CRAWlab/RoboBoat-2021/README.md

# RoboBoat 2021
General repository for the [University of Louisiana at Lafayette](https://louisiana.edu) entry into the [2021 RoboBoat competition](https://roboboat.org). Our ROS workspace is contained in a [separate repository](https://github.com/CRAWlab/roboboat).
