CRAWlab/RoboBoat-2021/docs/movies/ASV Simulation.md

<center>
  <a href="https://crawlab.github.io/RoboBoat-2021/">UAV</a>
  <a href="https://crawlab.github.io/RoboBoat-2021/Simulation">Simulations</a>
</center>

<p><center>
  <a href="https://crawlab.github.io/RoboBoat-2021/UAV Simulation">UAV Simulation</a>
  <a href="https://crawlab.github.io/RoboBoat-2021/ASV Simulation">ASV Simulation</a>
  <a href="https://crawlab.github.io/RoboBoat-2021/Blender">Blender</a>
  <a href="https://crawlab.github.io/RoboBoat-2021/Labelbox">Labelbox</a>
</center>
</p>

## 2021 UL Lafayette Ragin' Cajuns ASV Simulation

*More Coming soon...*
