CRAWlab/RoboBoat-2021/Technical Report/2021_RaginCajunsRoboBoat_TDR/TDR/Figures/ASV_fieldOfView_gray.pdf

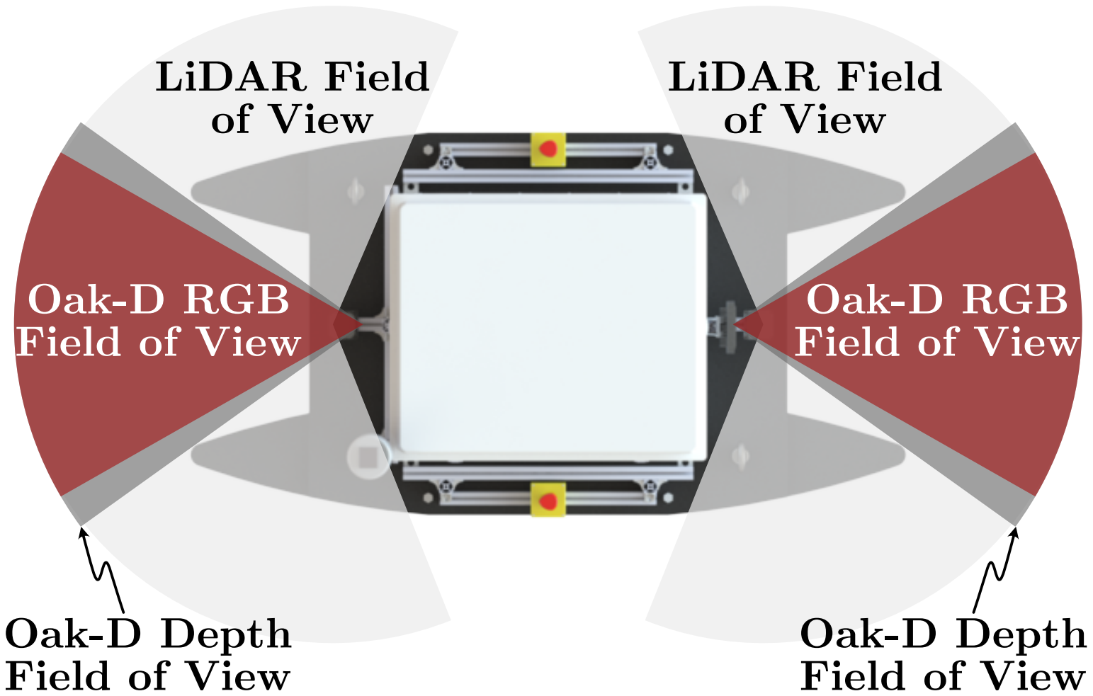
[picture p4: figure]
LiDAR Field of View; Oak-D RGB Field of View; Oak-D Depth Field of View
