CRAWlab/RoboBoat-2021/Technical Report/2021_RaginCajunsRoboBoat_TDR/TDR/Figures/uav_fully_labeled (2).pdf

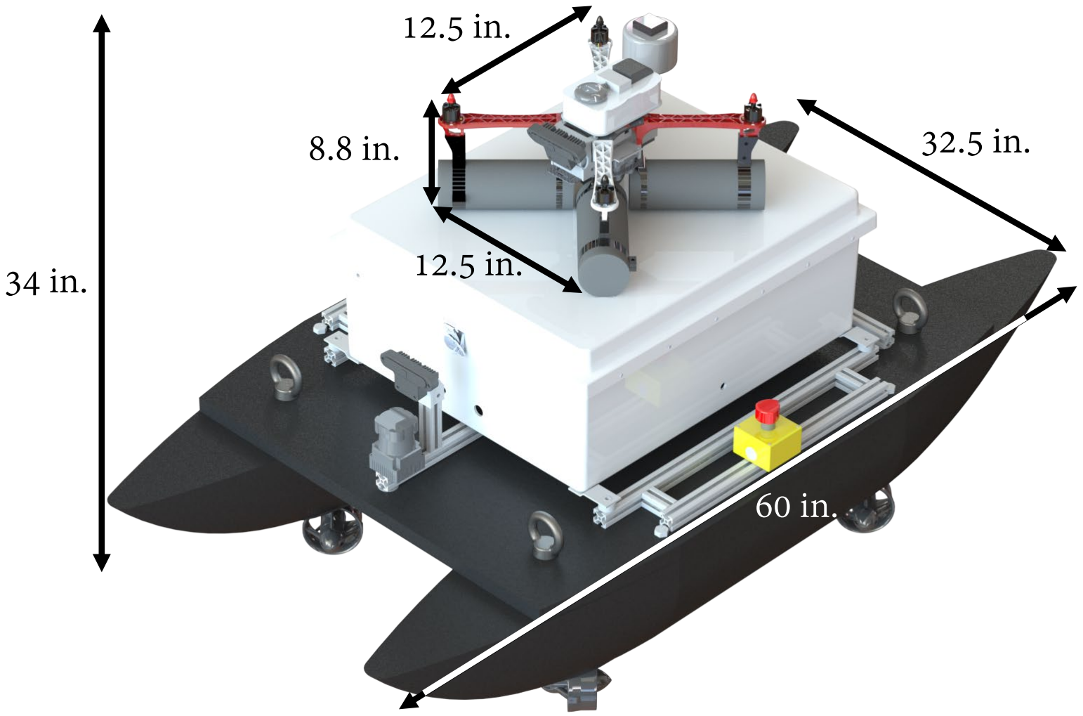
[picture p5: page 1]

32.5 in.

60 in.

34 in.

12.5 in.

8.8 in.

12.5 in.

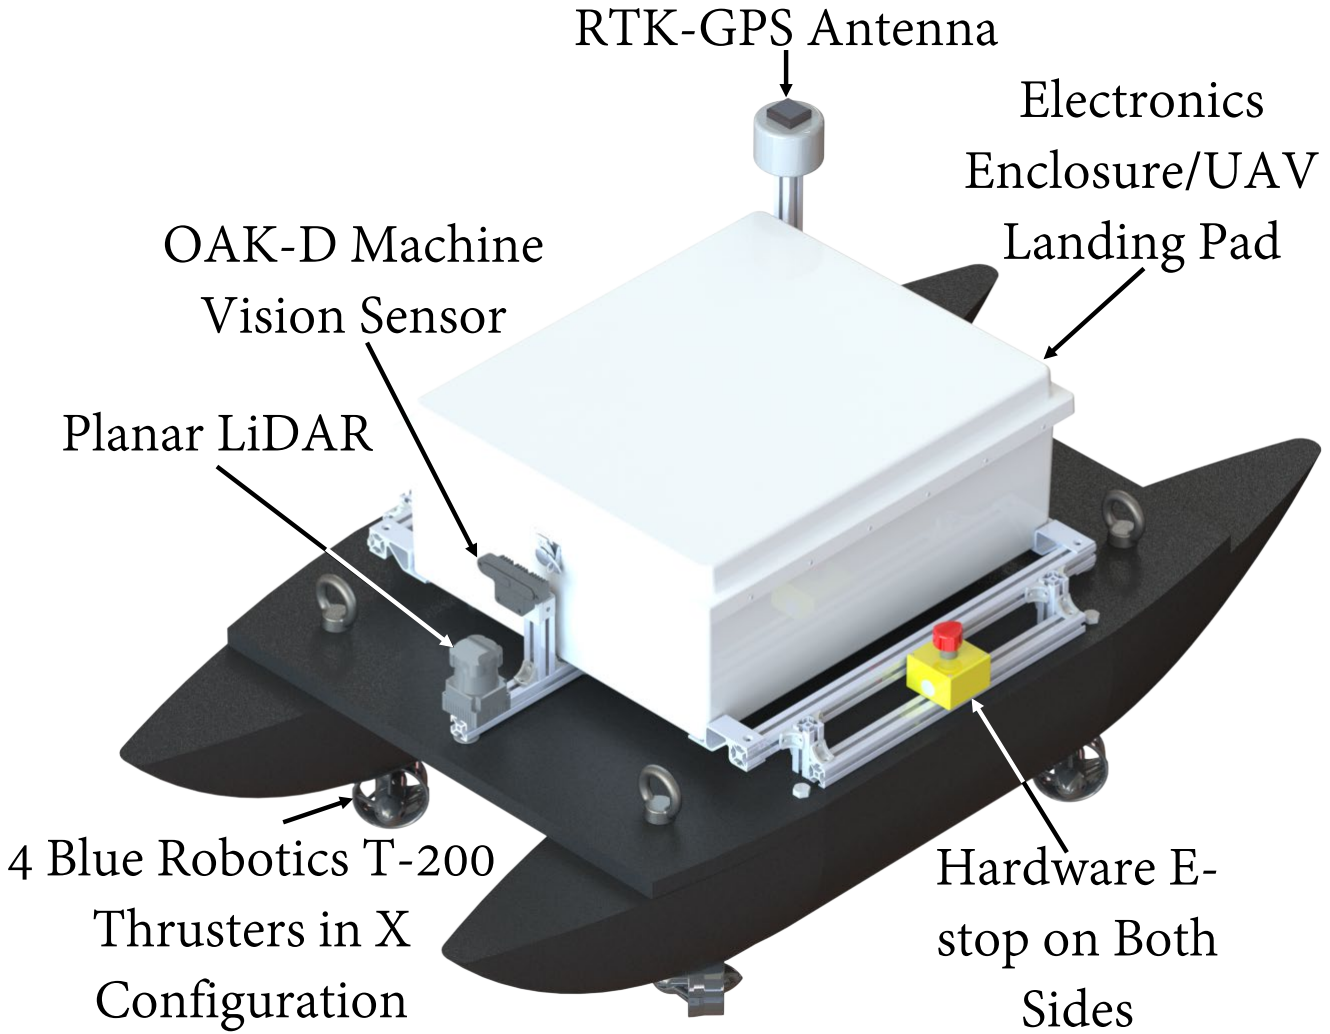
[picture p6: page 2]

Electronics
Enclosure/UAV
Landing Pad

Hardware E-stop on Both
Sides

4 Blue Robotics T-200
Thrusters in X
Configuration

Planar LiDAR

OAK-D Machine
Vision Sensor

RTK-GPS Antenna

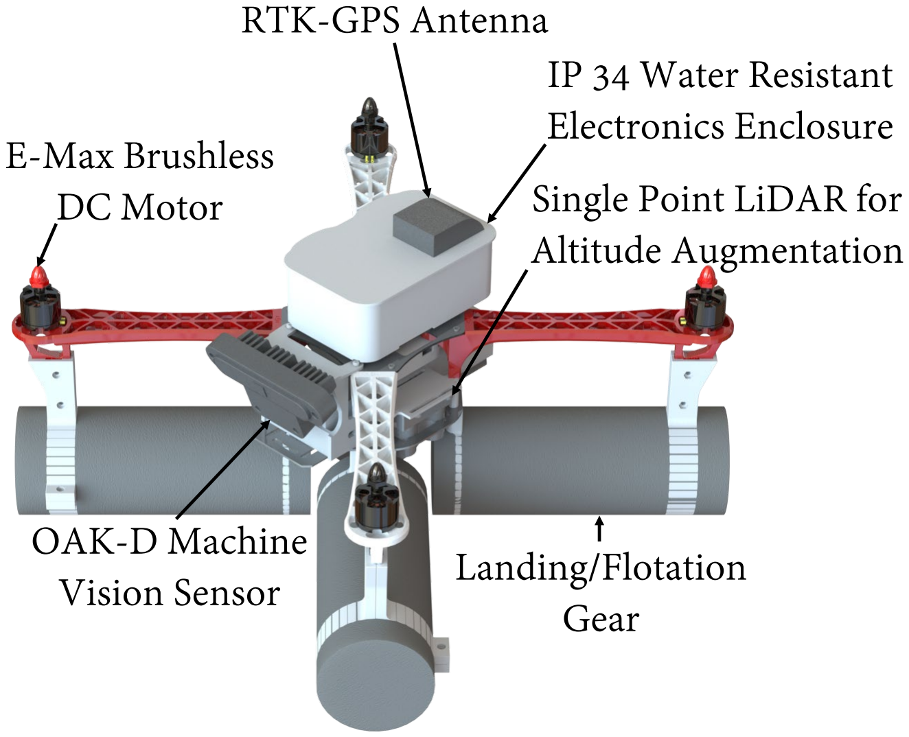
[picture p7: page 3]

IP 34 Water Resistant
Electronics Enclosure
E-Max Brushless
DC Motor

OAK-D Machine
Vision Sensor | Landing/Flotation
| Gear

Single Point LiDAR for
Altitude Augmentation

RTK-GPS Antenna

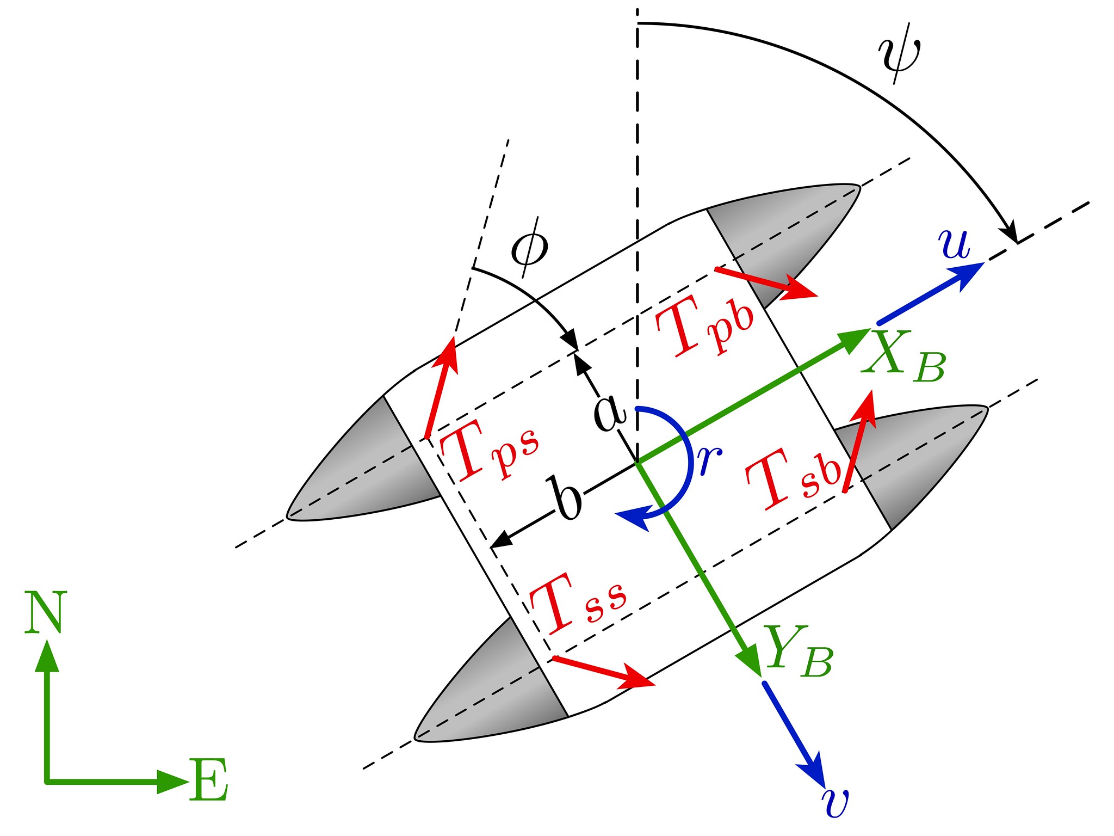
[picture p8: page 4]
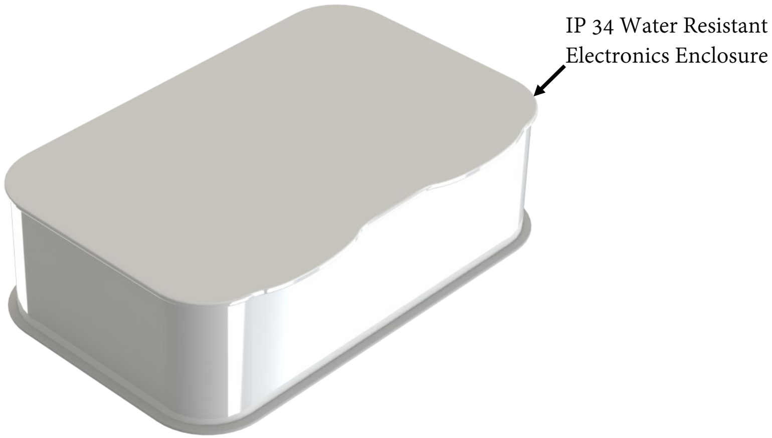
[picture p9: page 5]

IP 34 Water Resistant
Electronics Enclosure

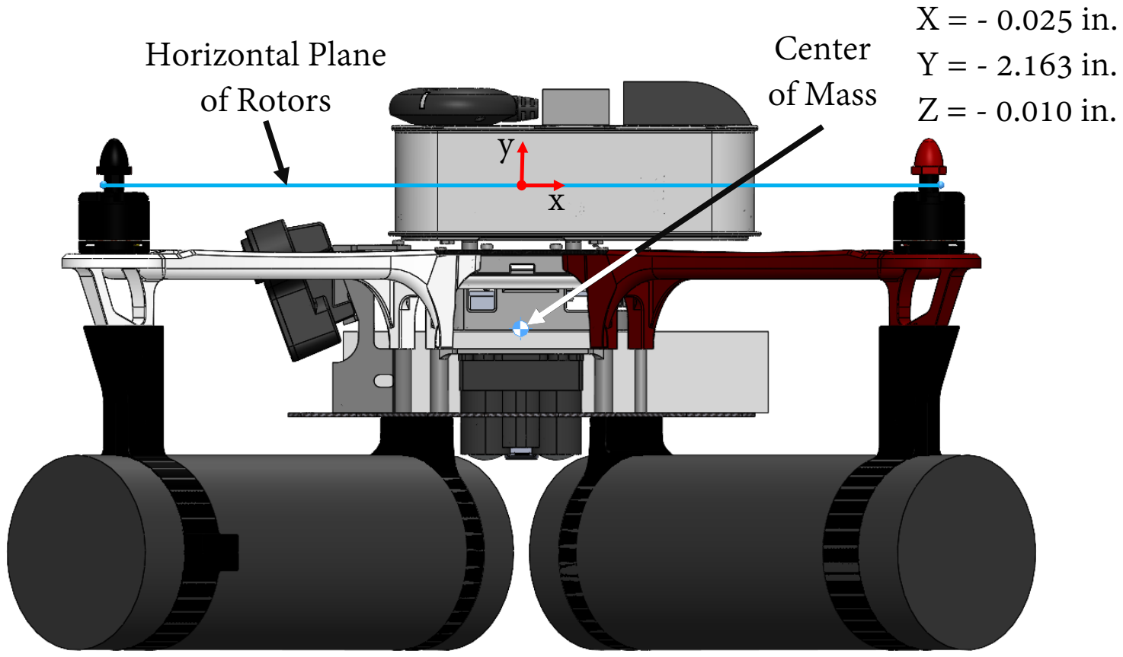
[picture p10: page 6]

y
x

Center
of Mass

X =

- 0.025 in.
Y =
- 2.163 in.
Z =
- 0.010 in.

Horizontal Plane
of Rotors

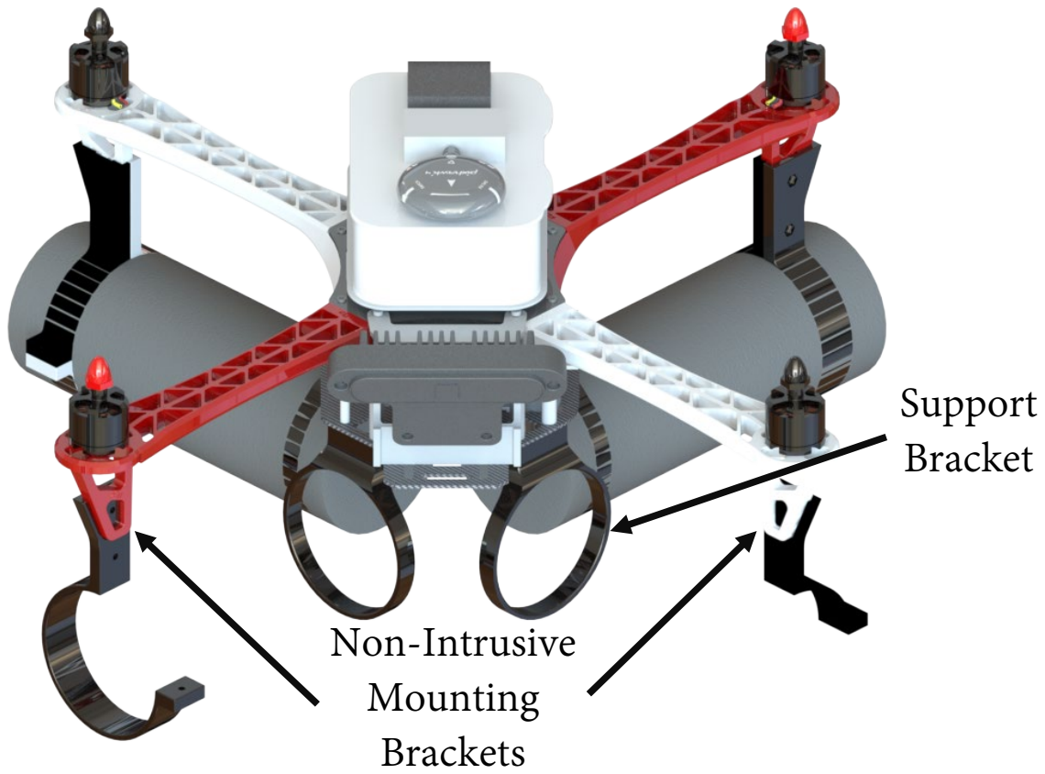
[picture p11: page 7]

Non-Intrusive
Mounting
Brackets

Support
Bracket

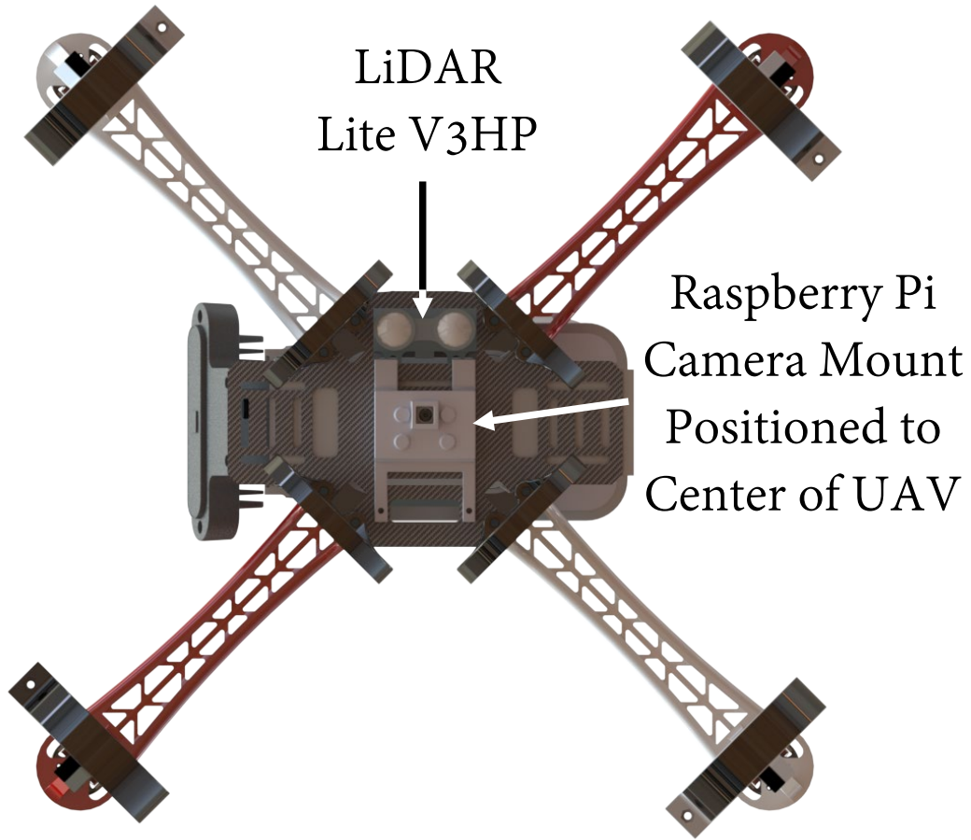
[picture p12: page 8]

### Raspberry Pi Camera Mount Positioned to Center of UAV

### LiDAR Lite V3HP

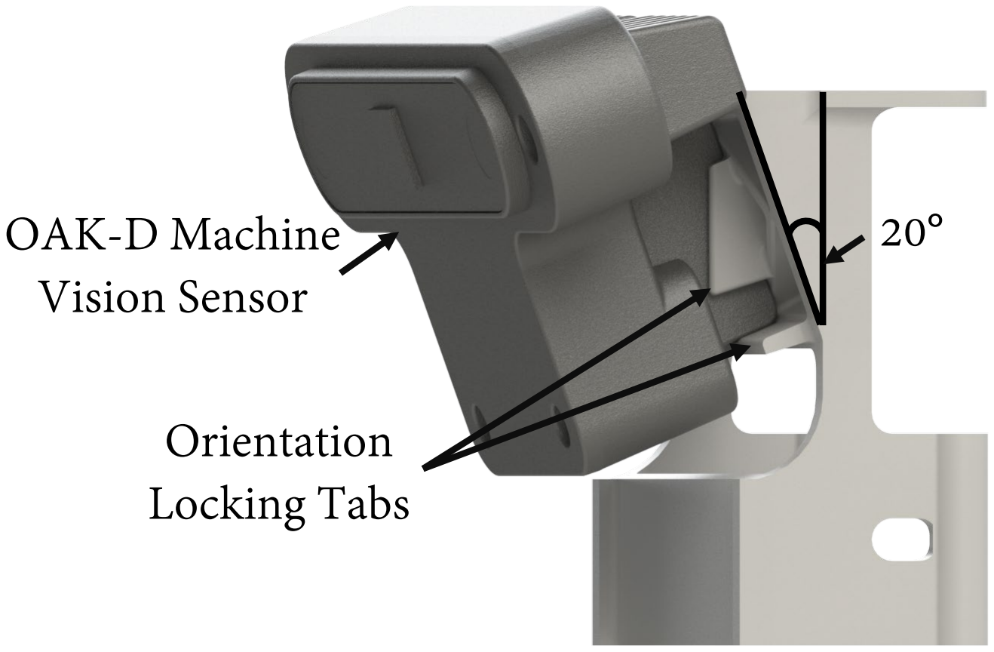
[picture p13: page 9]

### Orientation Locking Tabs

### OAK-D Machine Vision Sensor

20°

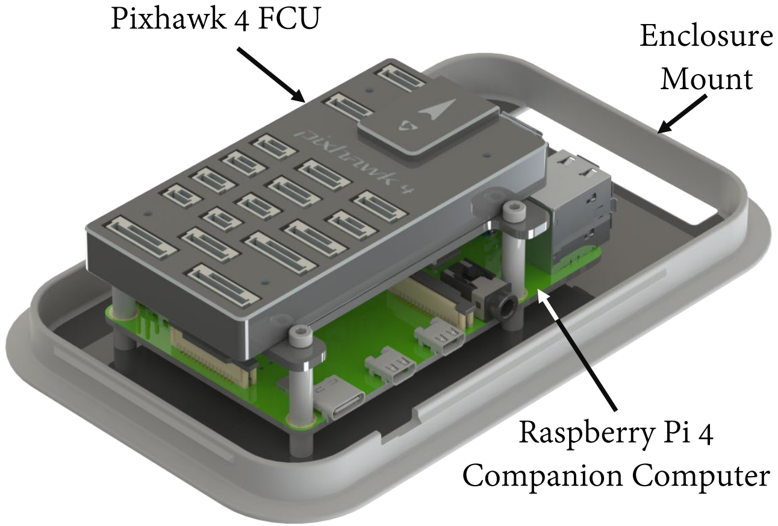
[picture p14: page 10]

### Pixhawk 4 FCU

### Raspberry Pi 4 Companion Computer

### Enclosure Mount

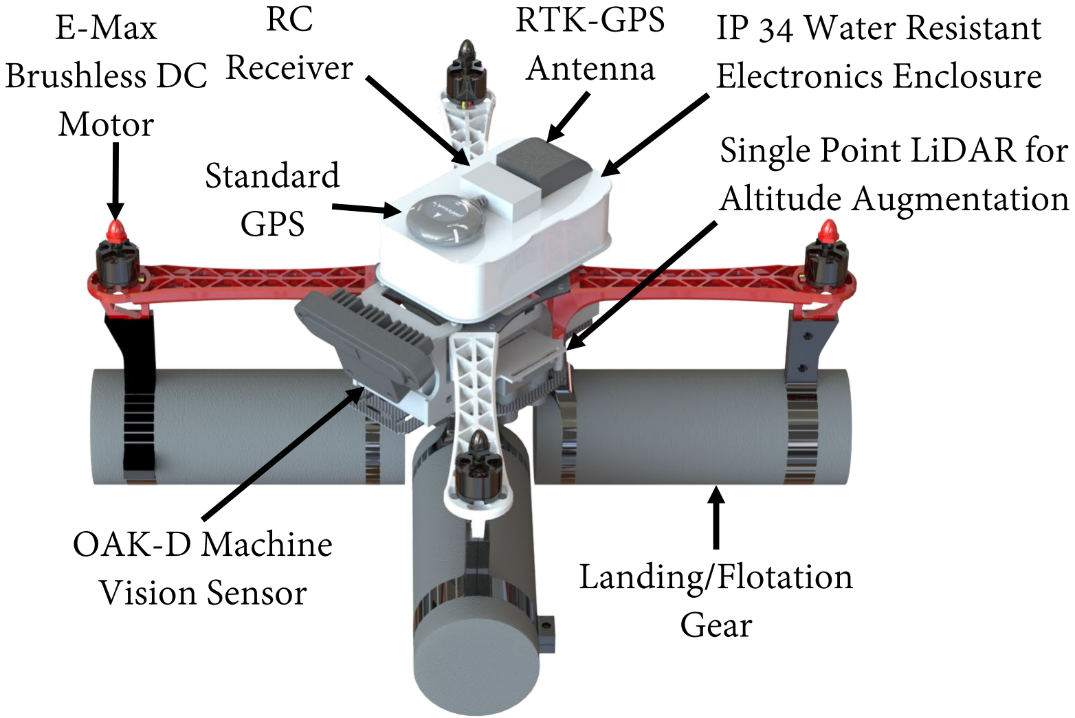
[picture p15: page 11]

IP 34 Water Resistant
Electronics Enclosure

E-Max
Brushless DC
Motor

OAK-D Machine
Vision Sensor | Landing/Flotation
| Gear

Single Point LiDAR for
Altitude Augmentation

RTK-GPS
Antenna

Standard
GPS

RC
Receiver

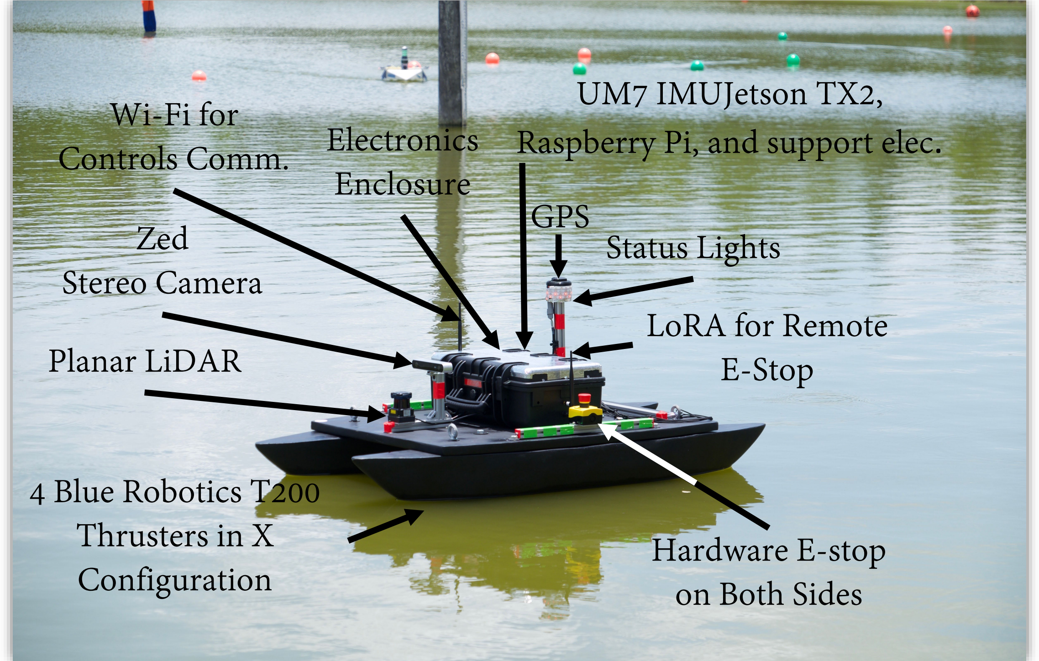
[picture p16: page 12]

Wi-Fi for
Controls Comm.
Zed
Stereo Camera
Planar LiDAR

4 Blue Robotics T200
Thrusters in X
Configuration

UM7 IMUJetson TX2,
Raspberry Pi, and support elec. GPS
Status Lights
LoRA for Remote
E-Stop

Hardware E-stop
on Both Sides

Electronics
Enclosure

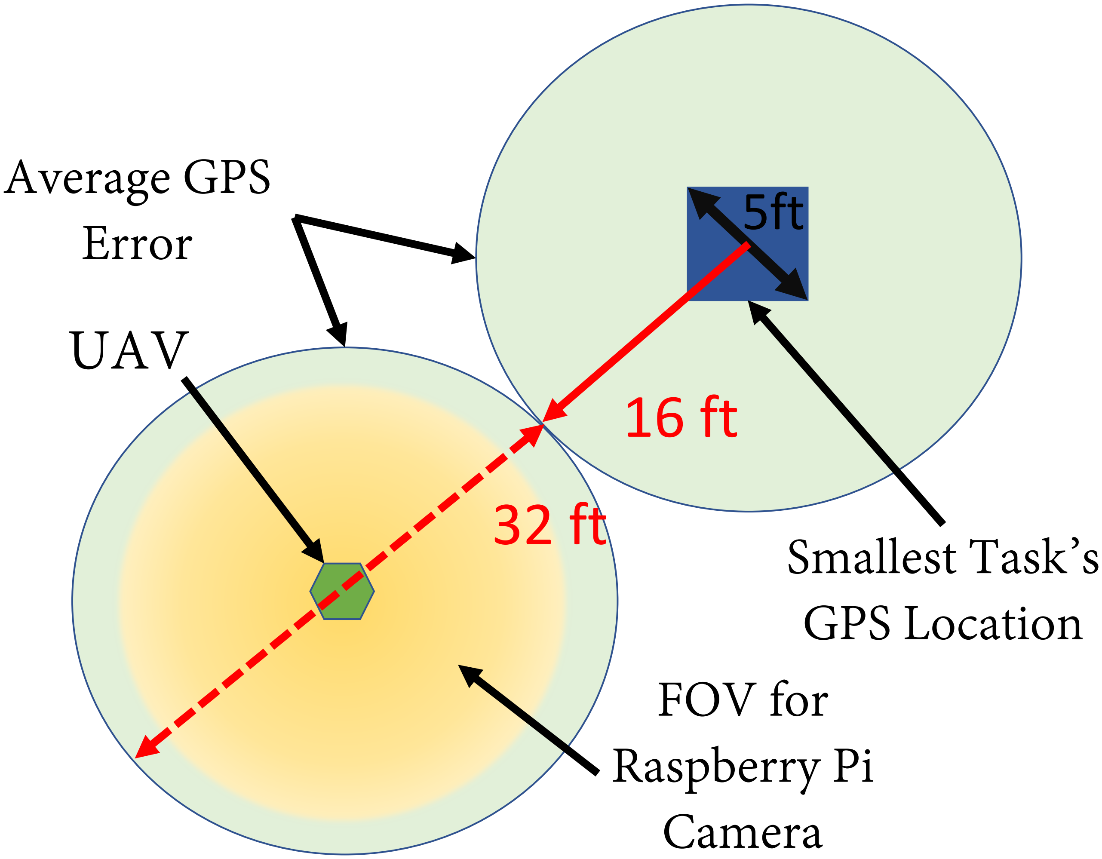
[picture p17: figure]
UAV; Smallest Task’s GPS Location; Average GPS Error; FOV for Raspberry Pi Camera

y
x

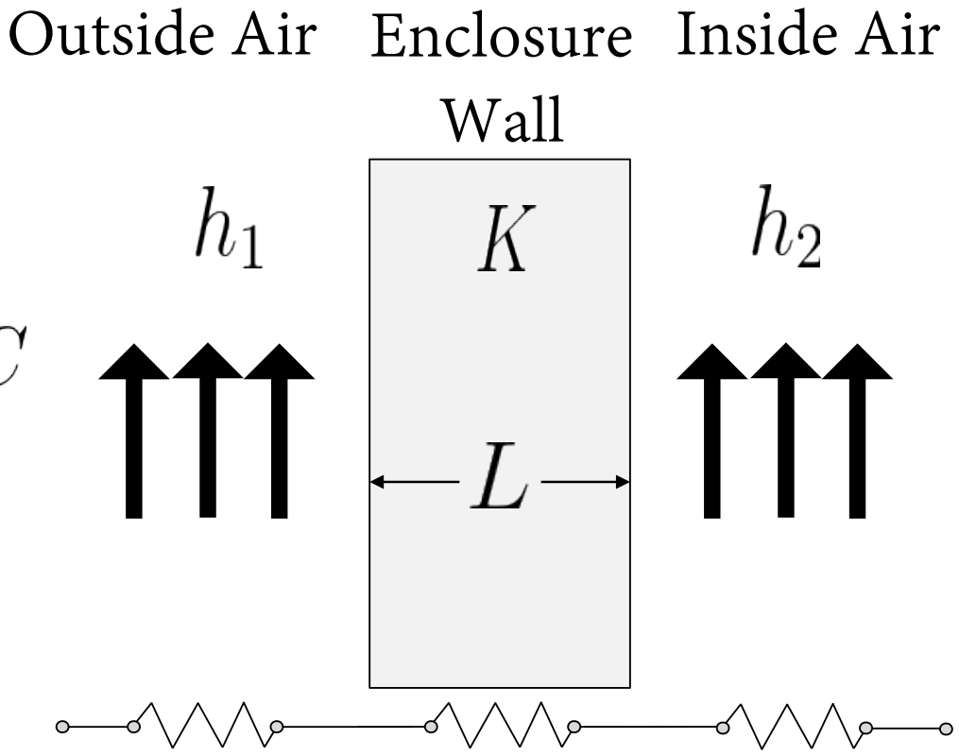
[picture p18: figure]
Outside Air Enclosure Inside Air Wall
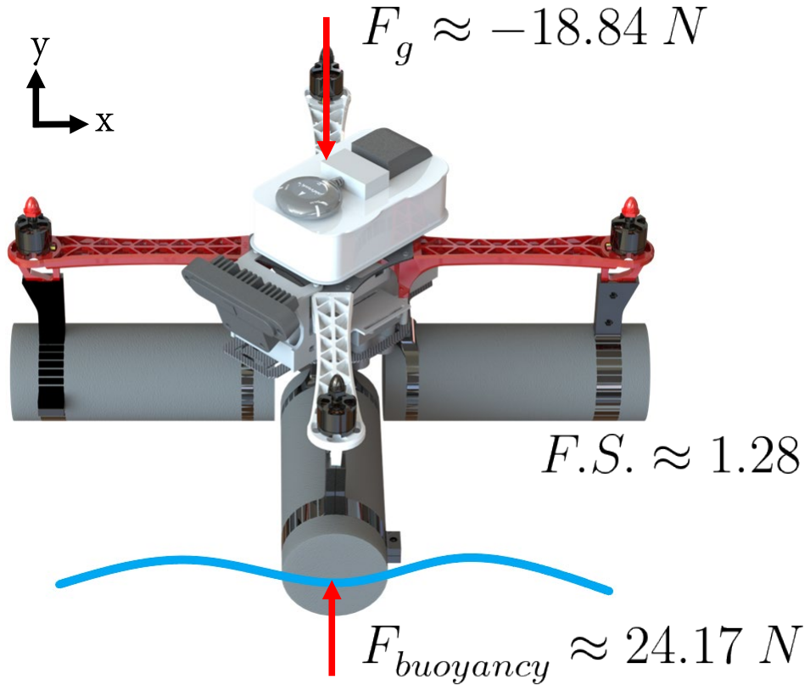
[picture p19: page 15]

y
x

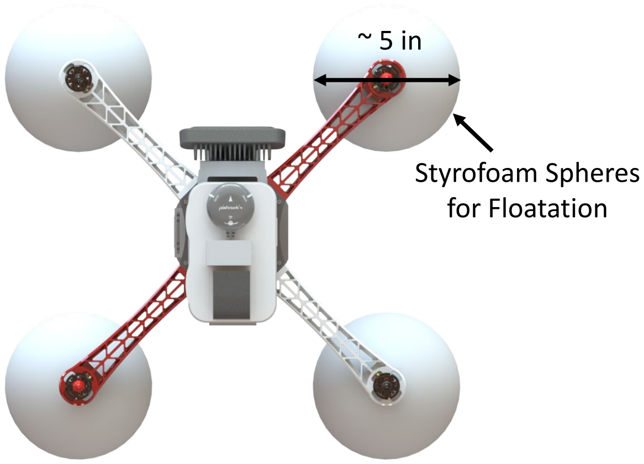
[picture p20: page 16]

Styrofoam Spheres
for Floatation

~ 5 in

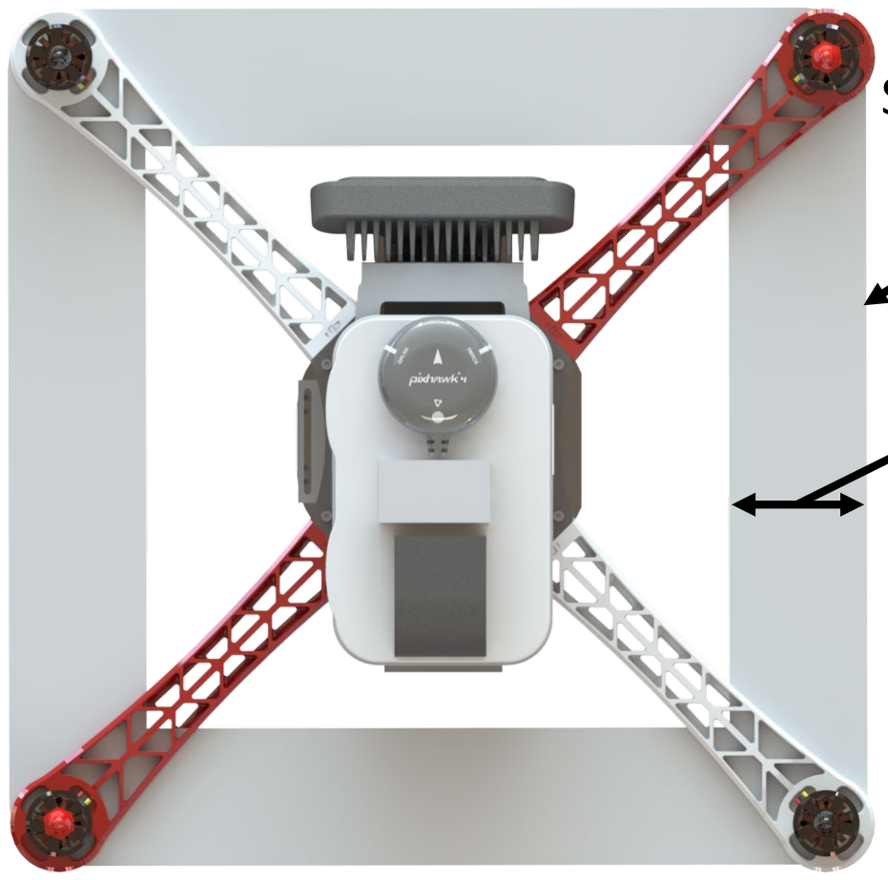
[picture p21: figure]

Styrofoam Square
for Floatation

~ 2.25 in

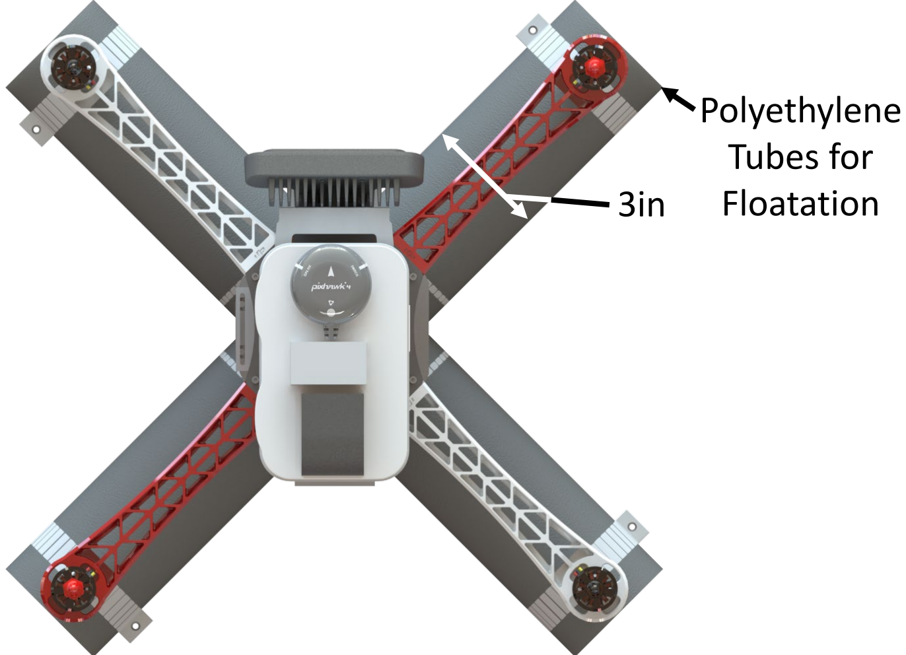
[picture p22: page 18]

Polyethylene
Tubes for
3in Floatation

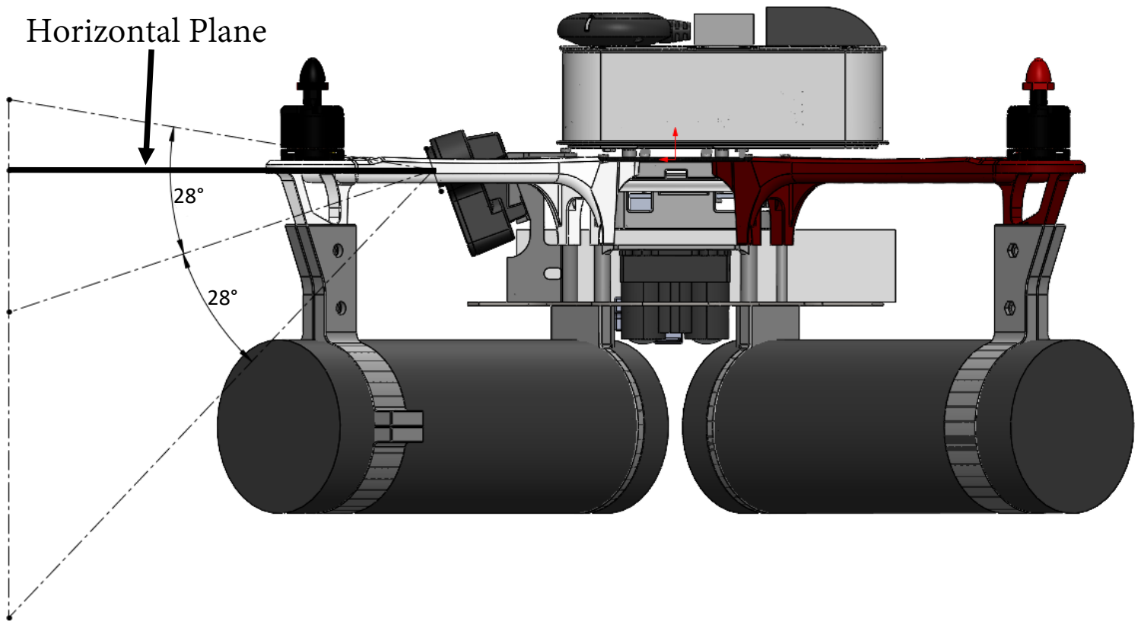
[picture p23: page 19]

28°

28°

Horizontal Plane

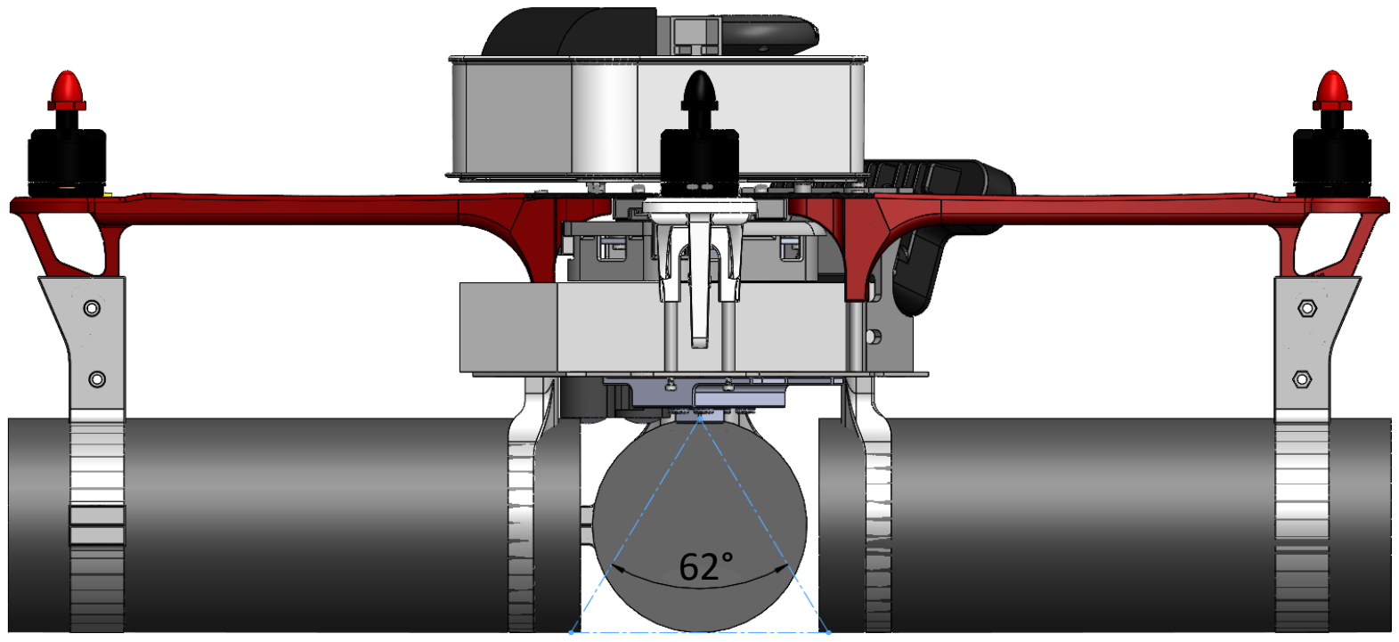
[picture p24: page 20]

6262°°

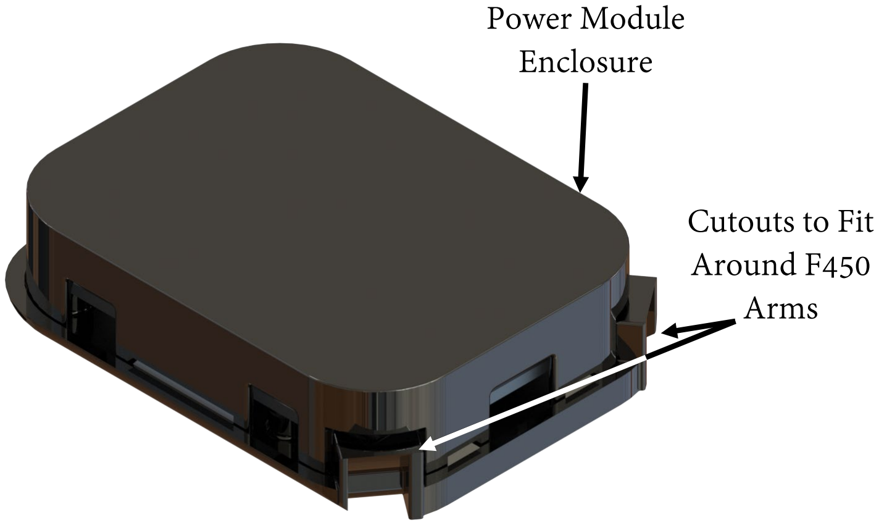
[picture p25: page 21]

Power Module
Enclosure

Cutouts to Fit
Around F450
Arms
