CRAWlab/RoboBoat-2021/Technical Report/2021_RaginCajunsRoboBoat_TDR/TDR/Final Submissions/RoboBoat_TDR_2021.pdf

Ragin’ Cajun RoboBoat | 1

# Ragin’ Cajuns RoboBoat–2021

### Captains: Adam Smith and Joseph Stevens Members: Brennan Moeller, Nathan Madsen, Benjamin Willis Coach: Joshua Vaughan¹ and Yasmeen Qudsi

Abstract— This report discusses the motivations behind the design choices and improvements to the University of Louisiana at Lafayette’s first entry to RoboNation’s RoboBoat Competition. These improvements include adding a new enclosure to house new electronics to aid in the enhancement of sensor capabilities and for the lid of this enclosure to be the launching/landing pad for the new unmanned aerial vehicle (UAV) that was added. This UAV will be an autonomous mobile sensor for the ASV to aid in mapping, localization, and navigation. The Ragin’ Cajuns RoboBoat is a catamaran-style vessel equipped with four thrusters in an “X”-Configuration, enabling holonomic motion. The computer network communicates with individual components via the Robot Operating System (ROS). The main contributions from the 2021 Ragin’ Cajuns RoboBoat team include improvements to localization of the system by adding Real Time Kinematic (RTK) GPS system, OAK-D machine vision to the bow and stern, and adding a UAV to act as a mobile sensor for the system..

I. INTRODUCTION
The 2021 RoboBoat competition requires teams to build an Autonomous Surface Vessel (ASV) capable of performing a variety of tasks. For an ASV to accomplish these tasks, several subsystems must function together. The University of Louisiana at Lafayette has developed a design to compete in the 2020 RoboBoat competition, shown in Figure 1. The ASV is equipped with two 2D LiDAR rangefinders and two stereo cameras for vision feedback, a GPS and IMU for
1Department | of | Mechanical | Engineering, | University
of Louisiana at Lafayette, Lafayette, LA 70504, USA joshua.vaughan@louisiana.edu

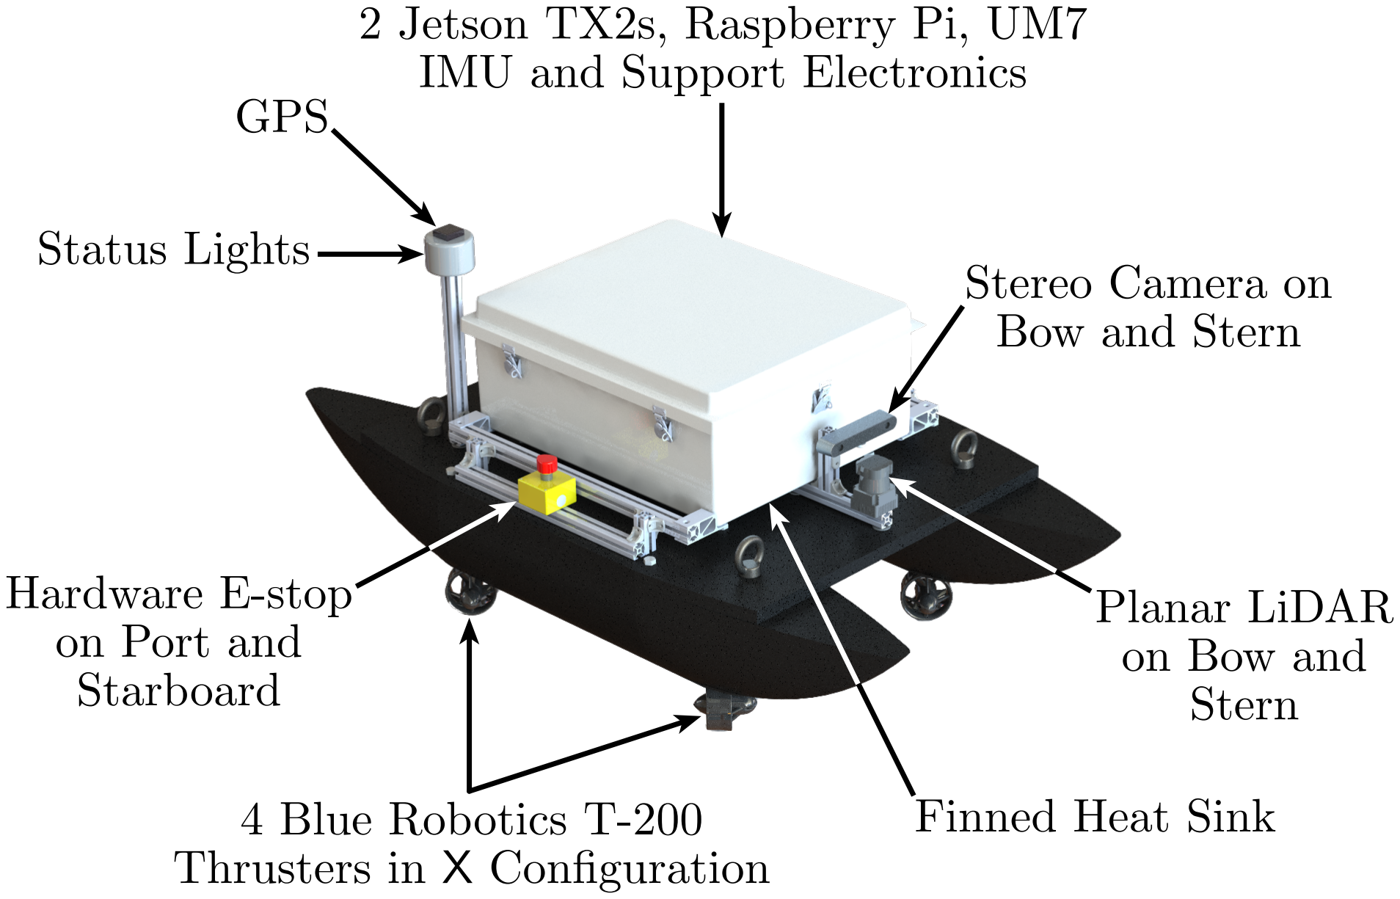
[picture p39: figure]
2 Jetson TX2s, Raspberry Pi, UM7 IMU and Support Electronics; GPS; Status Lights; Hardware E-stop on Port and Starboard; 4 Blue Robotics T-200 Thrusters in X Configuration; Finned Heat Sink; Planar LiDAR on Bow and Stern; Stereo Camera on Bow and Stern

Fig. 1: 2020 Ragin’ Cajuns RoboBoat CAD Model

localization, and four thrusters mounted in an “X”–Configuration, enabling holonomic motion. Because the in-person portion of this year’s competition was cancelled, the design process focused on upgrading and developing new tools used to test future designs.

II. COMPETITION STRATEGY
This section will discuss the 2020 Ragin’ Cajun RoboBoat team’s approach to completing the tasks set out by RoboNation for this year’s competition. The following subsections are in the order that the tasks would be attempted.
A. Navigation Channel
To demonstrate autonomy and ensure some level of course safety, this task is mandatory and must be completed before any other tasks can

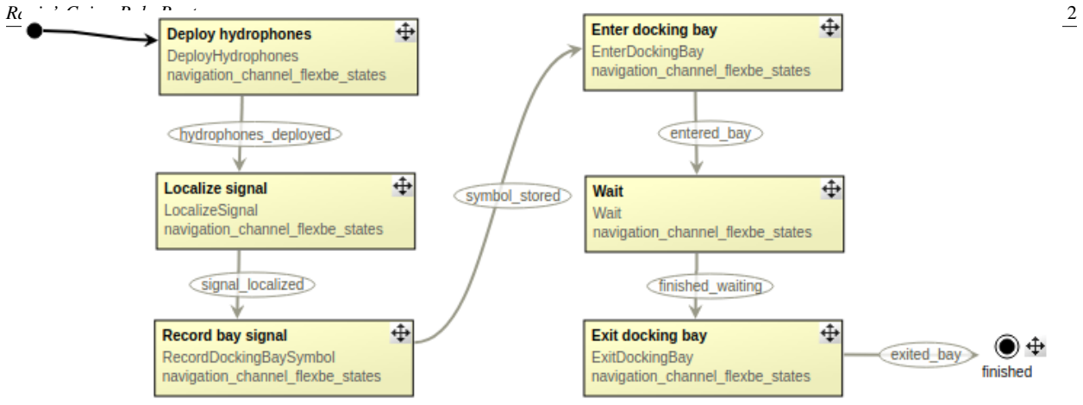
[picture p40: figure]
Ragin’ Cajun RoboBoat

Fig. 2: State Machine Behaviors for Acoustic Docking Task

be attempted. The ASV must pass through two sets of gates. Each gate consists of two buoys at least six feet apart. The two sets of buoys are at least 50 feet apart. The Ragin’ Cajuns RoboBoat is equipped with a stereoscopic camera that provides images to an image classifier trained by a Convolution Neural Network (CNN). The training set for this CNN consists of manuallylabeled images from the previous competition, as well as images from the 2016 Maritime RobotX Competition. The output of the image classifier is made available to a state machine that determines how the ASV should maneuver. For the Navigation Channel task, the state machine directs the ASV to find a gate, identified with green in the right side of the frame and red in the left. A waypoint goal is sent to the navigation stack to maneuver to the middle of the gate and orient the vessel to be in-line with the channel. The state machine instructs the ASV to maintain the initial heading as it continues to drive forward and look for the exit gate. Another waypoint between the exit gate is sent to the navigation stack as a target location. As the vessel reaches this waypoint, it completes the Navigation Channel and proceeds to the next task.

B. Acoustic Docking
This task requires the ASV to localize a signal and dock in its location. The state machine behaviors for this task are shown in Figure 2. Once the Navigation Channel task has been successfully completed, the state machine instructs the ASV to maneuver to the GPS coordinate provided for the entrance to the Acoustic Docking task, avoiding potential obstacles along the way. Once the ASV arrives at the docking station, two hydrophones are deployed from the vessel’s stern using a linear actuator. The ASV then circumnavigates the dock to generate a map of the area. Hydrophone feedback is processed to localize the active acoustic beacon and record its location. Once the signal has been located, if the docking station is not in view, the state machine will prescribe a waypoint away from the dock and instruct the ASV to adjust its heading to see the circle, cruciform, or triangle symbol associated with the recorded location. This symbol is identified using the image classifier and recorded, as it may affect the tasks that follow. The recorded location of the active acoustic beacon is then used as a waypoint to maneuver back to the dock. When the ASV has reached the target location, docking will commence. The ASV will station keep in the dock for five to ten seconds to confirm that it has successfully docked, and then exit the dock by setting the GPS coordinates for the Obstacle Channel task as its next waypoint.

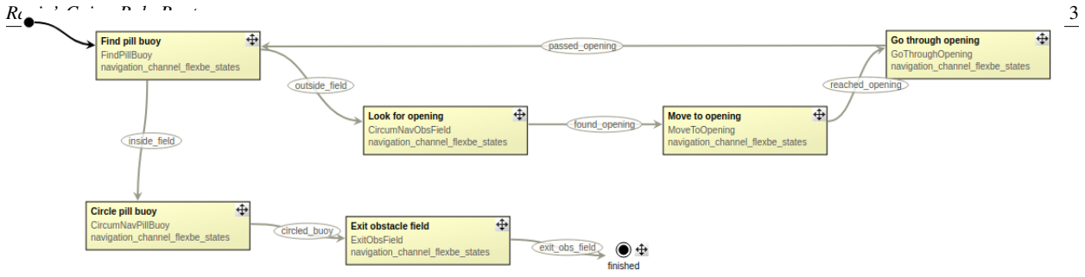
[picture p41: figure]
Ragin’ Cajun RoboBoat

Fig. 3: State Machine Behaviors for Obstacle Field Task

C. Obstacle Channel

The obstacle channel requires the ASV to maneuver through a series of gates with obstacle buoys along the trajectory. Unlike the Navigation Channel task, these gates are arranged in a non-linear trajectory. Because the Ragin’ Cajun RoboBoat hull footprint is large, this task may be difficult to complete. However, our ASV is also equipped with a holonomic thruster configuration. This allows the ASV to exert forces and moments in each degree of freedom independently. This increased maneuverability, along with restrictions on maximum allowable velocities, should aid the Ragin’ Cajun RoboBoat to complete this task. Once the ASV has arrived at this task from the Acoustic Docking station, the state machine will be checking for buoy color. It will be looking for green buoys in the right side of the image and red buoys in the right to identify the gates. The vision feedback system provided to the navigation stack will prevent the ASV from colliding with these green and red buoys as well as the yellow obstacle buoys. Waypoints are recursively placed at the middle of the gates. In order to know that the task has been completed, the GPS coordinate for the Obstacle Field task is iteratively appended to the waypoint sequence. When no more gates are in the field of view, the ASV will begin maneuvering to the Obstacle Field task because this waypoint is the last in the sequence. If red and green buoys in the Obstacle Field are misinterpreted as gates, the path planner will prevent the ASV from entering a region that it cannot fit because it knows the

base footprint area.

D. Obstacle Field

This task is attempted immediately after the Obstacle Channel task. The state machine behaviors for this task are shown in Figure 3. The Obstacle Field task is similar to the Obstacle Channel, but instead of gates, there is one “Pill Buoy”, which has distinguished markings, that the ASV must circumnavigate. This buoy is surrounded by several obstacles spaced as little as four feet apart. The Ragin’ Cajun RoboBoat team’s approach to this task is handled by collaboration between the high-level state machine and the path planner. The state machine will determine that the ASV is at the Obstacle Field by first identifying the Pill Buoy in the cameras’ field of view. The state machine will then place a waypoint toward the Pill Buoy to motivate the ASV to approach it. An entrance to the Obstacle Field is found by circumnavigating the field of buoys, iteratively updating the largest distance identified between the adjacent buoys. The path planner will then plan a trajectory through the obstacles while maintaining a safe distance from obstacles that is manually prescribed. This value is chosen as smaller than 50% of the difference between the minimum specified distance between obstacles the ASV can pass through, four feet, and the beam width of the Ragin’ Cajun RoboBoat. When the ASV has entered the Obstacle Field the current position is recorded, the state machine will command the path planner to circumnavigate the obstacle by placing waypoints around it. Once the Pill Buoy

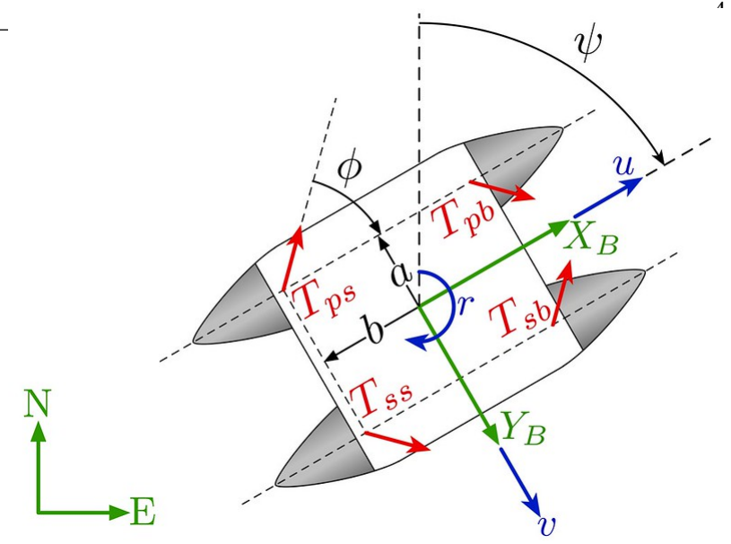
[picture p42: figure]

Ragin’ Cajun RoboBoat | 4
has been circled, and the ASV has changed its
heading by at least 360◦
, the ASV will exit the
Obstacle Field using the recorded position as the last waypoint and locating of a pair of buoys the computer vision system and path planner find wide enough for the ASV to fit.
E. Speed Gate

After the obstacle field has been successfully escaped, the ASV will maneuver to the GPS coordinate provided for the Speed Gate entrance. This task introduces a race element to the competition. The ASV is required to enter through a gate, travel to a buoy and circle it, and return through the gate as quickly as possible. Because of the new enclosure that was procured for this competition, the ASV thrust-to-weight ratio has decreased, hurting our possible performance at this task. However, the new optimal control strategy implemented for this year’s competition may be more effective than the velocity controller used at the previous competition. Additionally, the state machine overrides the velocity restrictions placed on the ASV by the path planner for this task so it can be completed as quickly as possible. A waypoint is placed at the gate entrance, and then the state machine instructs the ASV to pass through the gate at maximum speed. Once the target buoy has been located, waypoints are placed around it to it can be circumnavigated. The initial position at the gate is used as the final waypoint to guide the ASV out of the Speed Gate Challenge.

F. Return to Dock

Once all other tasks have been completed, the final task the ASV can complete is returning to the starting point of the course without encountering any obstacles. The ASV must pass through its own course, and not another where other vessels are competing. This is accomplished by recording the starting position upon entering the water, and then upon completing the final competition task, activating that saved location as a waypoint. While the ASV is completing other competition tasks, it will also be generating a map of the environment. In conjunction with its localization

Fig. 4: Free-Body Diagram of RoboBoat Thruster Configuration

and path planning capabilities, this will be used to maneuver the ASV back to the starting dock.

G. Object Delivery
This task requires the ASV to deliver up to four objects to a specified area in the course. The task may be completed solely by the ASV or by a combination of an ASV or Unmanned Aerial Vehicle (UAV). The 2020 Ragin’ Cajun RoboBoat team declined to develop this task to focus on other hardware and software upgrades. Should a task like this be introduced in future competitions, the Ragin’ Cajun RoboBoat would have been tasked with collecting images of the new course elements to enhance the image classifier training set, which currently has a limited supply of docklike images.

III. DESIGN CREATIVITY
A. Thrust Configuration
The thrusters are configured in an “X” pattern, and mounted at 45◦
angles, relative to the bow. A free-body diagram of this thruster configuration is shown in Figure 4 This enables holonomic motion, or motion in all three degrees of freedom independent of each other. This improves the maneuverability of the RoboBoat through tasks like the Obstacle Channel or Obstacle Field. It also assists in docking since the RoboBoat can move

Ragin’ Cajun RoboBoat | 5
in the positive or negative sway directions and
does not have to do a forward–reverse maneuver,
such as a car parallel parking.
Though this thrust configuration was used on the 2019 Ragin’ Cajun entry to the competition, the design was only equipped with one stereo camera and LiDAR. This meant that there was a 90◦ region that no visual measurements were being taken, so it was possible that, with a mapping error, the 2019 RoboBoat would apply reverse or sway thrust and encounter an obstacle. Because the 2020 design has two LiDAR systems and stereo cameras, the blind spot is removed.
B. Control Strategy
The 2020 Ragin’ Cajun RoboBoat control system has been upgraded from last year’s entry to use Model Predictive Control (MPC). This is an optimal control method that solves for the optimal input sequence over the next n time steps given the current states of the system by minimizing a cost function. The first input in the optimal control sequence is supplied to the system and the process is repeated. Using this new optimal control strategy requires some system parameters to be estimated so the equations of motion can be solved to predict trajectories.
Figure 5 illustrates this process for a single degree of freedom system tracking a constant setpoint. In Figure 5a, the controller calculates the optimal control sequence and the system advances to a new state. For the next time step, shown in Figure 5b, new initial conditions are provided to the controller and the optimal control sequence is computed again. The trajectory and predicted states have also extended one step past their positions in Figure 5a.
The equations of motion describing the dynamics of the Ragin’ Cajun RoboBoat are [1], [2]:

Mν˙ +C(ν)ν +D(ν)ν = τ +τ wind +τ wave (1)

η˙ =

x˙ y˙ ψ˙

T
| (2)

ν =

u v rT | (3)

where M is an inertia matrix, ν is a vector of

body-fixed velocities, C (ν) is a Coriolis matrix | ...
(a) Time t

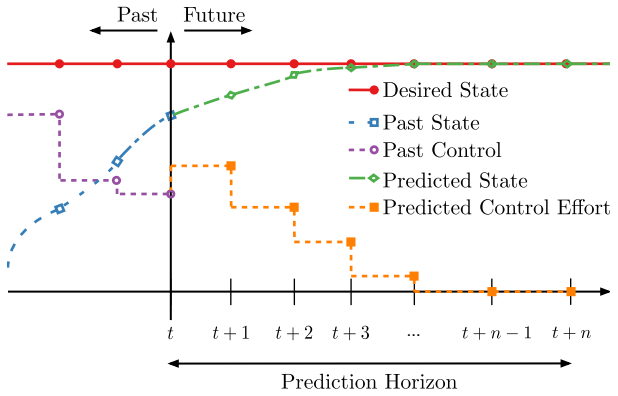
[picture p43: figure]

(b) Time t +1

Fig. 5: Model Predictive Control Process for a Single Degree of Freedom System

and D (ν) is a hydrodynamic drag matrix. The parameters of the C (ν) and D (ν) matrices must be determined empirically.
The controller minimizes a quadratic cost function given by:

J (x,u) =

n
∑

0

x

TQx +u

TRu
(4)

Q = Diag-0.5 0.5 1.0 0.8 0.5 0.1

(5)

R = Diag-

0.001 0.001 0.001 0.001 (6)

x =

R
(νd −ν)dt
(νd −ν)
(7)

u =

Tpb | Tps | Tsb | TssT
(8)

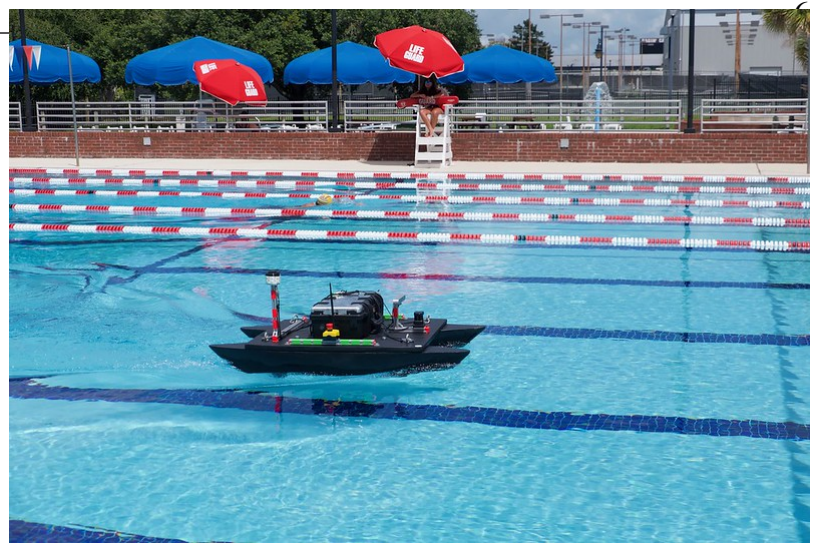
[picture p44: figure]

Ragin’ Cajun RoboBoat | 6
where Q and R are diagonal matrices, x is the
vector of state error from the set of desired
states, and u is the control input vector. Further
experimental testing is required to fully tune the cost function weights.
C. Thermal Energy Management

This year’s team was fortunate enough to receive a generous donation from Hammond Manufacturing and AWC, Inc. The team was unable to configure the new electronics enclosure, but it has been integrated into our CAD model of the vessel. Because the electronics have been upgraded to include an additional CPU, the team was concerned about the amount of heat generated in the enclosure, which is does not allow airflow. The old enclosure was a black polypropylene case with a half-inch wall thickness. The new enclosure is a fiberglass case that increases the enclosure volume by 160%. Furthermore, the enclosure has been elevated and equipped with two aluminum finned plates. This allows more space for air flow and a larger external surface area to convect excess heat, but at the cost of an additional 10 pounds of weight. This does reduce the Ragin’ Cajun RoboBoat’s maximum speed and thrust-to-weight ratio.
Though more weight is being added, preliminary calculations show that given the average temperature conditions at the 2019 competition, this enclosure will convect approximately 51% more energy off of the enclosure surface based on the increased area. This does not take the change in temperature resulting from a gray surface into consideration.

IV. EXPERIMENTAL RESULTS

A. Pool Testing

To develop parts of the system model, the Ragin’ Cajun RoboBoat was taken to a university pool to perform system identification trials, shown in Figure 6. These trials were performed using with the old enclosure, but by estimating the increased draft increase the following parameters have been identified. These same system identification trials have been performed on another catamaran-style

Fig. 6: Ragin’ Cajun RoboBoat Performing System ID Trials

vessel [3], [4]. Because the hull properties are similar, the hydrodynamic added mass terms and nonlinear drag terms have been estimated using their formulations. The hydrodynamic drag and added mass term estimations for the adjusted weight with the new enclosure are shown in Table I. The values follow the SNAME convention, meaning subscripts represent drag force in that degree of freedom [5]. For the nonlinear drag terms, the subscripts represent drag in the first subscript due to motion in the second subscript’s degree of freedom. The terms Xu and Xuu correspond to linear and nonlinear drag in surge. Because the vessel’s weight has increased by 20% with the added enclosure, these parameters will need to be recollected. The other parameters are empirically defined, but may be adjusted if the waterline length or draft is different than the new estimate from the additional enclosure weight.

B. System Simulation
1) Gazebo: The biggest contribution of this team to the continued development of the Ragin’ Cajun RoboBoat is the foundation for a system simulation in Gazebo. The RoboBoat spawns in the Sand Island World from the Virtual Maritime RobotX Competition [6], shown in Figure 7. Here, the image classifier training is being tested on its ability to recognize the buoys. The classifier uses “You Only Look Once” (YOLOv3) [7], trained using the CNN described in Section II-A. The

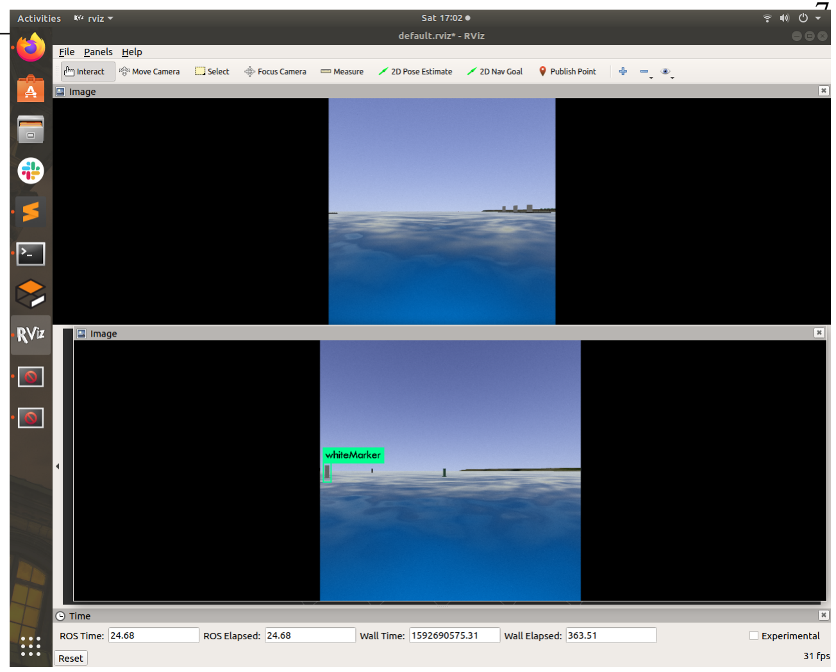
[picture p45: figure]

Ragin’ Cajun RoboBoat | 7
TABLE I: System Parameters
Item | Value
Mass | 32.042 kg
Moment of Inertia (Z) | 2.987 kgm²
Draft | 0.1214 m
Loa | 1.524 m
Lwl | 1.2827 m
Lcg | 0.3191 m
Boa | 0.8128 m
B | 0.5588 m
Bh | 0.2351 m
Xu | 55.5 kg/s
Xuu | 4.1 kg/s
Yv | See [3], [4]
Yr | See [3], [4]
Nv | See [3], [4]
Nr | See [3], [4]
Yvv | 171.292 kg/s
Yvr | 55.190 kgm/s
Yrv | 55.190 kg/s
Yrr | 41.268 kgm/s
Nvv | 55.190 kg/s
Nvr | 41.268 kgm/s
Nrv | 41.268 kg/s
Nrr | 29.123 kgm/s
Xu˙ | −1.602 kg
Yv˙ | −53.451 kg
Yr˙ | −11.926 kgm
Nv˙ | −11.926 kg
Nr˙ | −17.713 kgm

simulation is based on the Heron Simulation from Clearpath Robotics [8]. The ROS network onboard the RoboBoat computer systems and sensors has been migrated to generic, configurable sensors with open-source plugins to simulate data such as point clouds, laser scans, and wind and wave effects.
The ACADO toolkit is used to generate a MPC controller [9]. Several other nodes are used to perform localization or act as components in the ROS Navigation Stack. The current configuration still needs lots of tuning, but the 2020 Ragin’ Cajun RoboBoat team decided that focusing on developing this platform as a tool for future competitions would be the best course of action.
2) Computational Fluid Dynamics: With a completed CAD model, the team would like to verify the hand calculations for the convection heat transfer from the enclosure surface and perform thermal analyses within the enclosure itself.

Fig. 7: Testing the RoboBoat Image Classifier in Sand Island

Though it is not ready for this year’s competition, the updated CAD model will be used to generate these system characteristics before the 2021 competition, and may result in further hardware upgrades such as an air circulation system to be included within the enclosure.

V. CONCLUSIONS
This report analyzed the design of the 2020 Ragin’ Cajun RoboBoat, including key software, hardware, and strategic improvements. This design builds on the Ragin’ Cajuns’ previous entry to the RoboBoat Challenge, and now utilizes Model Predictive Control, an optimal control strategy. The sensor configuration that the RoboBoat is equipped with now eliminates a blind spot that limited the usefulness of the holonomic thruster configuration. Contributions made by this team to furthering ASV development at the University of Louisiana at Lafayette include a Gazebo simulation of the RoboBoat system and an updated CAD model. Competition strategies employed and documented by this team may serve useful to future Ragin’ Cajun RoboBoat team members.

VI. ACKNOWLEDGMENTS
This project would not be possible without the guidance and support of our Coach, Dr. Joshua

Ragin’ Cajun RoboBoat
8
Vaughan. The team would like to thank him for his patience with us and willingness to assist us wherever possible. The 2020 Ragin’ Cajun RoboBoat team would also like to thank Hammond Manufacturing and AWC, Inc. for their generous donation of a new and improved electronics enclosure. The team was unable to install it because of restricted access to university facilities, but it will make its debut in the 2021 Ragin’ Cajun RoboBoat entry.

REFERENCES

[1] T. I. Fossen, Guidance and Control of Ocean Vehicles. John Wiley and Sons, Ltd., 1994.
[2] ——, Handbook of Marine Craft Hydrodynamics and Motion Control. John Wiley and Sons, Ltd., April 2011.
[3] W. B. Klinger, I. R. Bertaska, K. D. von Ellenrieder, and
M. R. Dhanak, “Control of an unmanned surface vehicle with uncertain discplacement and drag,” IEEE Journal of Oceanic Engineering, vol. 42, pp. 458–476, April 2017.
[4] E. I. Sarda, H. Qu, I. R. Bertaska, and K. D. von Ellenrieder, “Station-keeping control of an unmanned surface vehicle exposed to current and wind disturbances,” Ocean Engineering, vol. 127, pp. 305–324, November 2016.
[5] SNAME, “Nomenclature for treating the motion of a submerged body through a fluid,” The Society of Naval Architects and Marine Engineers, Tech. Rep., 1950.
[6] B. Bingham, C. Aguero, M. McCarrin, J. Klamo, J. F. Malia, ¨
K. Allen, T. Lum, M. Rawson, and R. Waqar, “Toward maritime robotic simulation in gazebo,” in OCEANS 2019 ,
2019.
[7] J. Redmon and A. Farhadi, “Yolov3: An incremental improvement,” University of Washington, Tech. Rep., 2018.
[8] C. Bogdon. Heron usv gets a new simulator.
[9] B. Houska, H. J. Ferreau, and M. Diehl, “Acado toolkit – an open source framework for automatic control and dynamic optimization,” Optimal Control Applications and Methods ,
vol. 32, no. 3, pp. 298–312, 2011.

Ragin’ Cajun RoboBoat | 9
APPENDIX

TABLE II: Ragin’ Cajun RoboBoat Specifications

Category | Item | Vendor | Specifications | Quantity | Price ($)
Actuation | HDA4-2 | ServoCity | 4” Stroke
| | | 25lb Thrust | 1 | 129.99
Battery | 4S Li-Po | Turnigy

16V
5200 mAh
450g
4 | 53.96
Battery | 3S Li-Po | Floureon

12V
4500 maH
324.5g
2 | 33.29
Comm. | TL-WA901ND | TP-Link

2.4-2.4835 GHz
270m range
12V, 1A
5.8W
1 | 37.99
Computing | Pi 3B+ | Raspberry Pi | ARMv8, 1.4 Ghz
1GB DDR2 RAM | 2 | 35.00
Computing | Jetson TX2 | NVIDIA

256 CUDA Cores
2-Core Denver 2
4-Core Cortex-A57
8GB DDR4 RAM
2 | 629.99
Enclosure | PJ24208RT | Hammond MFG

0.064 m³
Fiberglass
11 kg
1 | Donated
Hull | Fiberglass
| Cloth | TotalBoat | 6 oz
yard² | 10.56 yard²
56.01
Hull | Epoxy | TotalBoat | 1.18 g
cm³ | 4.31 kg | 126.99
Hull | Fairing
| Compound | TotalBoat | 1.32 g
cm³ | 2.27 kg | 56.99
Propulsion | T-200 | Blue Robotics

[−4.1,5.25] kgf
76mm Propeller
156g (in water)
390W, 24A (max)
4 | 169.00

Ragin’ Cajun RoboBoat | 10
Propulsion | Speed
Controllers

Blue
Robotics

16.3g
7–26V
30A (max)
[1100,1900] µs
4 | 25.00
Sensing | H2C
Hydrophone

Aquarian
Audio

(0.01,100) KHz
0.3mA
2KΩ Impedance
Omnidirectional
25mm x 58mm
51g
≤80 meters
2 | 169.00
Sensing | Scarlet 2i2 | Focusrite | (0.02,20) KHz 1.5MΩ
1 | 159.99
Sensing | UM6 IMU | CH Robotics

500 Hz
≤ 2
- Pitch, Roll
≤ 5
- Yaw
5V
±2000◦
/s rotation
±2g accel.
1 | 1260.00
Sensing | Ultimate GPS
Breakout V3 | Adafruit

66 Channels
10 Hz
5V, 20mA
1 | 39.95
Vision | UTM-30-LX-EW | Hokuyo

270◦ FOV
2D Projection
30 meter range
100 Hz
2 | 4900.00
Vision | ZED
Stereo Camera | Stereolabs

4MP
1080p HD, 30 FPS
WVGA, 100 FPS
380mA / 5V
170g
90◦

, 60◦

, 100◦

2 | 449.00
