CRAWlab/RoboBoat-2021/docs/_posts/2021-05-11-welcome-to-jekyll.markdown

---
layout: page
title:  Meet the Team
permalink: /Meet the Team/
---

<h1 style="text-align:center;"> 2021 UL Lafayette Ragin' Cajuns RoboBoat </h1>

Welcome to the [University of Louisiana at Lafayette's](https://louisiana.edu) entry 
into the [2021 RoboBoat Competition](https://roboboat.org/programs/2021/). This is 
the Ragin' Cajuns' third design submission to RoboBoat. We are very excited to show 
off our progress throughout the past nine months, so please take a look and enjoy! 

<!-- Meet the 2021 RoboBoat Team -->

<!--
  ### **Dr. Joshua Vaughan**
      - Write about how he has guided this team to the success it is at and he has 
always been there for us!
      - Are these appropriate to use?
        - [C.R.A.W. LAB](https://userweb.ucs.louisiana.edu/~jev9637/)
        - [Dr. Vaughan - Louisiana Introduction Page](https://mechanical.louisiana.
edu/node/155)
        - [Github Page](https://github.com/DocVaughan)
        - Any other links to add?
      - Email: *joshua.vaughan@louisiana.edu*
-->

<!--
  ### *Ms. Yasmeen Qudsi*
      - Write about how Yasmeen has repeatedly gone out of her way to make sure this 
team is taken care of to make sure this team becomes a success!
          - This includes how she helped teach us to solder, helped water-jet four 
parts for us, given us some tricks and trades for making sure we are doing 
the correct "things" with electronics.
      - Is this appropriate to use?
        - [Ms. Qudsi - Louisiana Introduction Page](https://mechanical.louisiana.edu/
node/163)
      - Any other links to add?
      - Email: *yasmeen.qudsi@louisiana.edu*
-->
<br />
<br />

<h1 style="text-align:center;">Meet the 2021 RoboBoat Team </h1>

  <h3 style="text-align:center;"> Team Members </h3>

  <h4 style="text-align:left;"><b>Joseph Stevens: Team Captain</b></h4>

  <div style="float:left; padding:25px; margin-left:0px;">
  <a >JosephStevens</a><script async src="//embedr.flickr.com/assets/client-code.js" charset="utf-8"></script>
  </div>

<br />
 
  - Joe was responsible for leading this team. He also worked with Dr. Vaughan to create an enviorment of the RoboBoat Competition Layout in Blender. From there Joe was able to take images of the Blender envornment and run them through an algorithm that would be able to identify the different colored buoys in the system. <!-- Please update for us -->

  - [Joe's LinkedIn](https://www.linkedin.com/in/joseph-stevens-69b2a1206)
<br />
<br />
<br />
<br />
<br />
<br />

  <h4 style="text-align:left;"> <b> Brennan Moeller </b></h4>

  <div style="float:left; padding:25px; margin-left:0px;">
 <a title="Brennan_Headshot">Brennan_Headshot</a><script async src="//embedr.flickr.com/assets/client-code.js" charset="utf-8"></script>
  </div>

<br />
 
  - Brennan was responsible for managing this teams comminications with our clients and advisors. Brennan was also responsible for implementing the Docker containers on all computers and creating an upgraded network system for the addition of the UAV to the previous system among other various tasks 

  - [Brennan's LinkedIn](https://www.linkedin.com/in/brennan-moeller-b31ba7163/)
  
<br />
<br />
<br />
<br />

  <h4 style="text-align:left;"> <b> Benjamin Willis </b></h4>

  <div style="float:left; padding:25px; margin-left:0px;">
<a >50350092_00301_0161_Large</a><script async src="//embedr.flickr.com/assets/client-code.js" charset="utf-8"></script>
</div>
<br />
 
  - Ben was responsible for creating part files for the UAV. He was also resposible for inputting the UAV into simulation as well as testing the drone to make sure it works in both simulation and in real life. Finally, Ben was also responsible for creating this webpage from scratch.

  - [Ben's LinkedIn](https://linkedin.com/in/BenjaminRWillis)

<br />
<br />
<br />
<br />
<br />

  <h4 style="text-align:left;"> <b> Nathan Madsen </b></h4>

  <div style="float:left; padding:25px; margin-left:0px;">
  <a title="Nathan_Headshot">Nathan_Headshot</a><script async src="//embedr.flickr.com/assets/client-code.js" charset="utf-8"></script>
  </div>

<br />
 
 <!-- Please update for us -->
  - Nathan was responsible for creating custom mounts for the LiDAR Lite and Raspberry Pi Camera. He also was responsible for collecting image data from the OAK-D Stereo camera.

  - [Nathan's LinkedIn](https://linkedin.com/in/nathan-madsen-ab9aa01a9)

<br />
<br />
<br />
<br />
<br />

  <h4 style="text-align:left;"> <b> Adam Smith </b></h4>

  <div style="float:left; padding:25px; margin-left:0px;">
<a >DSC_4279(1)</a><script 
async src="//embedr.flickr.com/assets/client-code.js" charset="utf-8"></script>

  </div>

<br />
 
 <!-- Please update for us -->
  - Adam was the Graduate Student on this project. He specialized in understanding the way that the ASV actually moves in real time and where its faults are at that could be improved upon.

  - [Adam's LinkedIn](https://www.linkedin.com/in/adam-smith-377694159)

<br />
<br />
<br />
<br />
<br />
<br />

  <h3 style="text-align:center;"> Faculty Advisors </h3>

<p style="float:left;text-align:center; width: 30%; margin-right: 0%; margin-left: 20%">
	<strong style="text-align:center;"></strong><br>
   <a >JoshuaVaughan-2</a><script async src="//embedr.flickr.com/assets/client-code.js" charset="utf-8"></script>
  <br />
  Dr. Joshua Vaughan
</p>
<p style="float:left;text-align:center; width: 30%; margin-right: 0%; margin-left: 
0%">
	<strong style="text-align:center;"></strong><br>
  <a >Qudsi-Yasmeen-MCHE-web</a><script async src="//embedr.flickr.com/assets/client-code.js" charset="utf-8"></script>
  <br />
  Ms. Yasmeen Qudsi
</p>

<br />
<br />
<br />
<br />
<br />
<br />
<br />
<br />
<br />
<br />
<br />
<br />
<br />

<!-- Please add if there are other people involved in this years comp.   ### **Anyone 
else?** -->

<h3 > UL Lafayette 2021 RoboBoat Competition Details </h3> 

 - [TDR]()
 - [Skills Video: Sensor Optimization]()
 - [Demonstration Video]()
 - [Team Poster](../files/MCHE_484_Final_Poster.pdf)
 - [Flickr](https://www.flickr.com/photos/crawlab/albums/72157715576359036/with/51186939985/)
 - [GitHub Repository](https://github.com/CRAWlab/RoboBoat-2021)
 - [Vimeo](https://vimeo.com/channels/ullafayetteroboboat)
