CRAWlab/RoboBoat-2021/docs/assets/images/Adam_Headshot.jpg

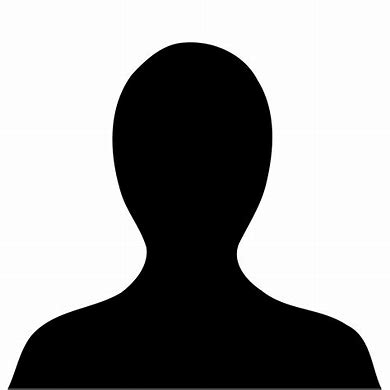
docs/assets/images/Adam_Headshot.jpg
