CRAWlab/RoboBoat-2021/docs/assets/images/Brennan_Headshot.jpg

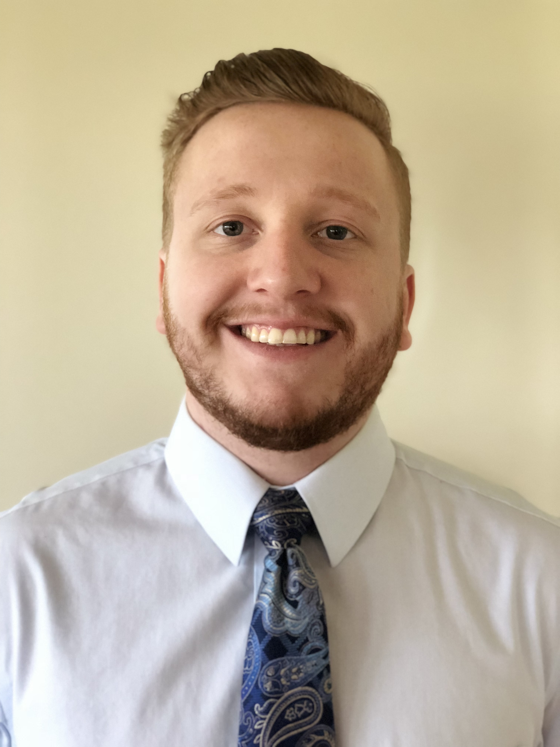
docs/assets/images/Brennan_Headshot.jpg
