CRAWlab/RoboBoat-2021/docs/assets/images/hammondmfg.PNG

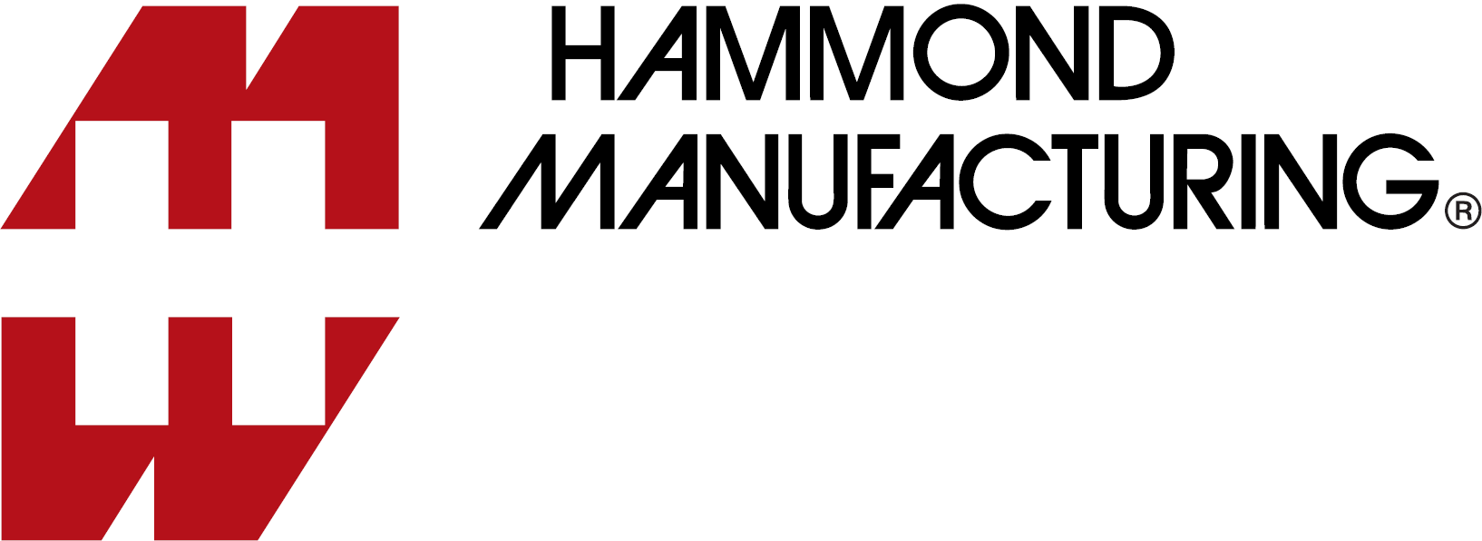
docs/assets/images/hammondmfg.PNG
