CRAWlab/RoboBoat-2021/docs/assets/images/Nathan_Headshot.jpg

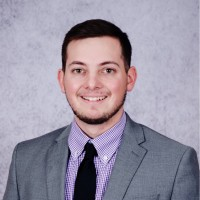
docs/assets/images/Nathan_Headshot.jpg
