CRAWlab/RoboBoat-2021/docs/assets/images/Yasmeen_Headshot.jpg

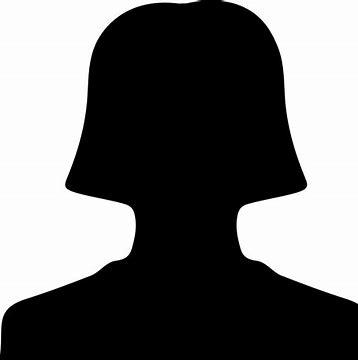
docs/assets/images/Yasmeen_Headshot.jpg
