CRAWlab/RoboBoat-2021/docs/images/ASV_Electronics_Teardown_1.jpg

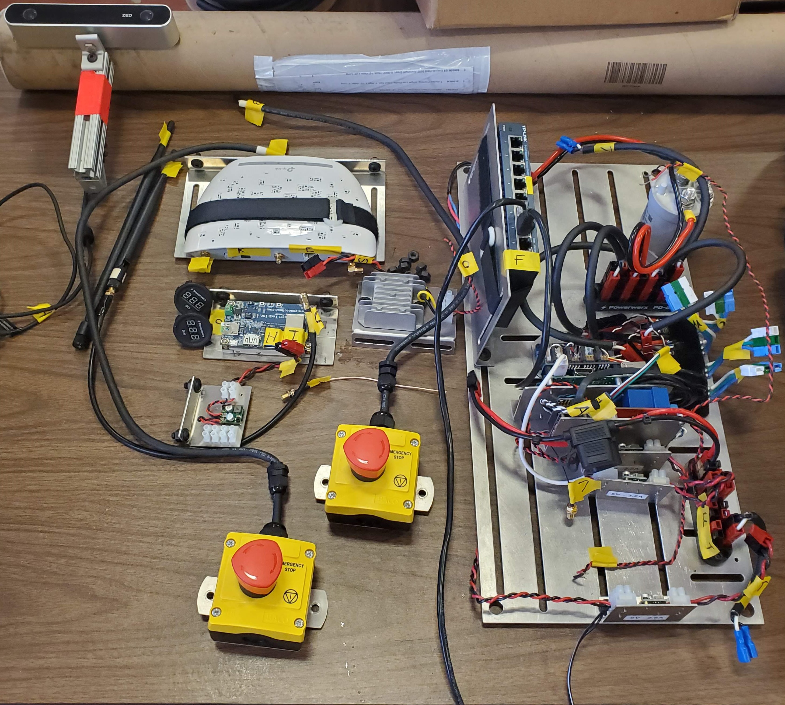
docs/images/ASV_Electronics_Teardown_1.jpg
