CRAWlab/RoboBoat-2021/docs/images/ASV_Enclosure_Teardown.jpg

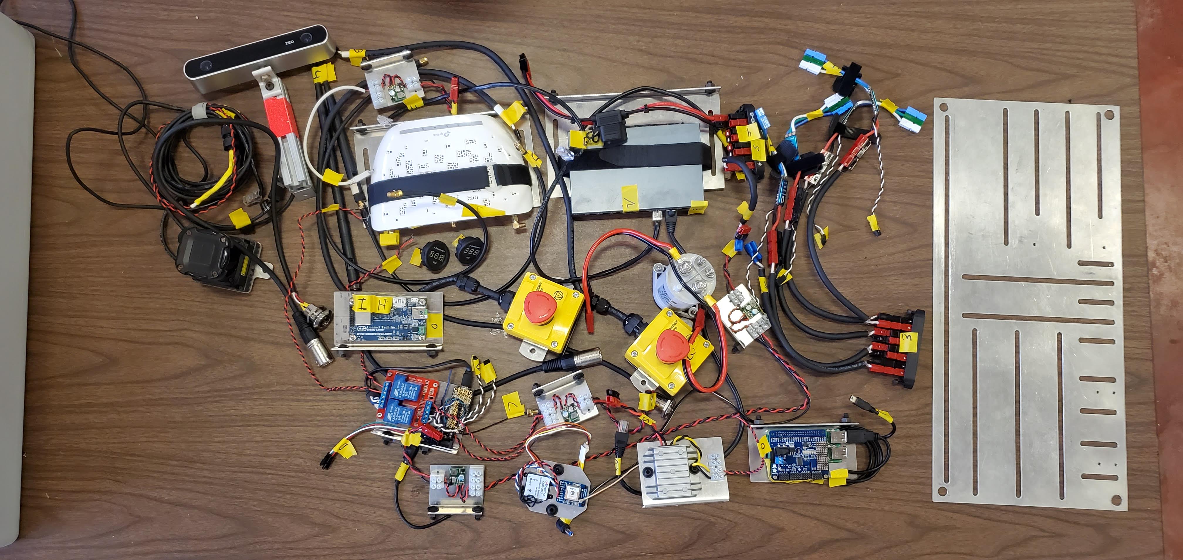
docs/images/ASV_Enclosure_Teardown.jpg
