CRAWlab/RoboBoat-2021/docs/images/ASV_Full.png

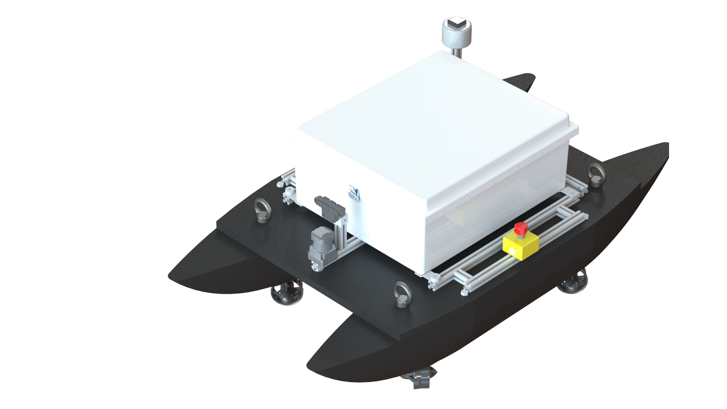
docs/images/ASV_Full.png
