CRAWlab/RoboBoat-2021/docs/images/Current_ASV_State.JPEG

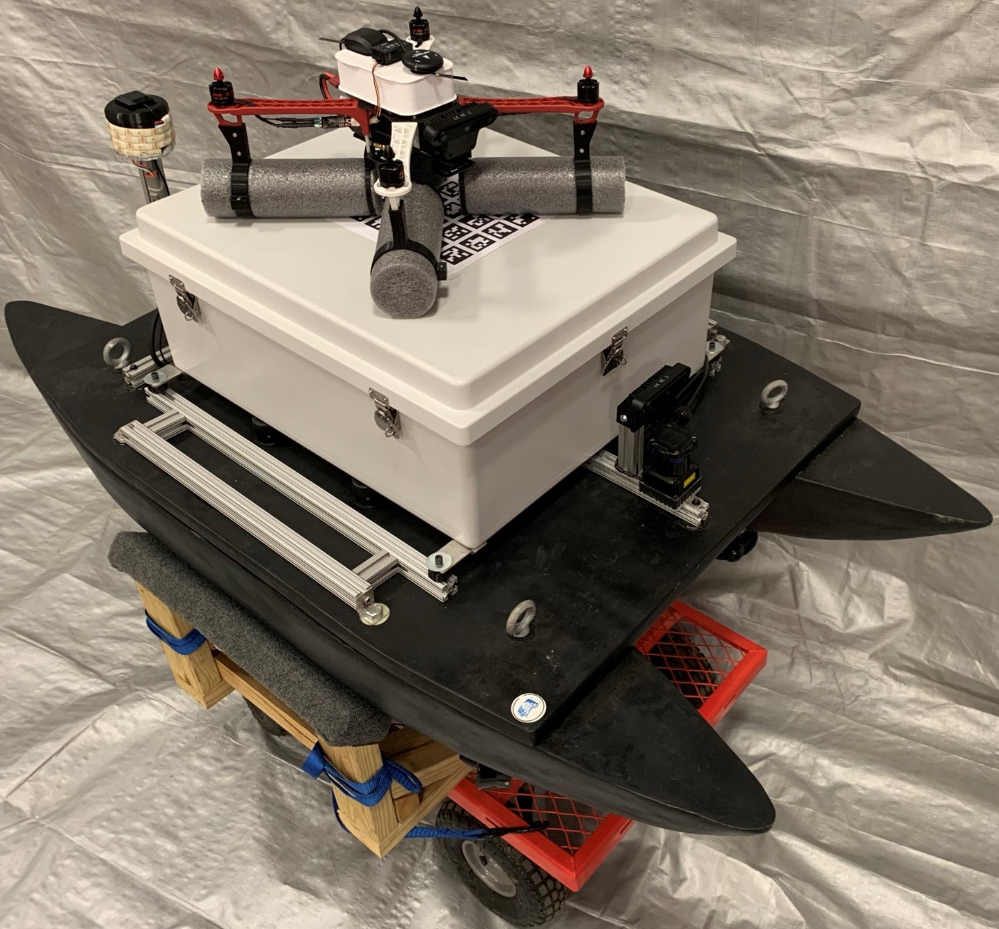
docs/images/Current_ASV_State.JPEG
