CRAWlab/RoboBoat-2021/docs/images/New_ASV_CAD.png

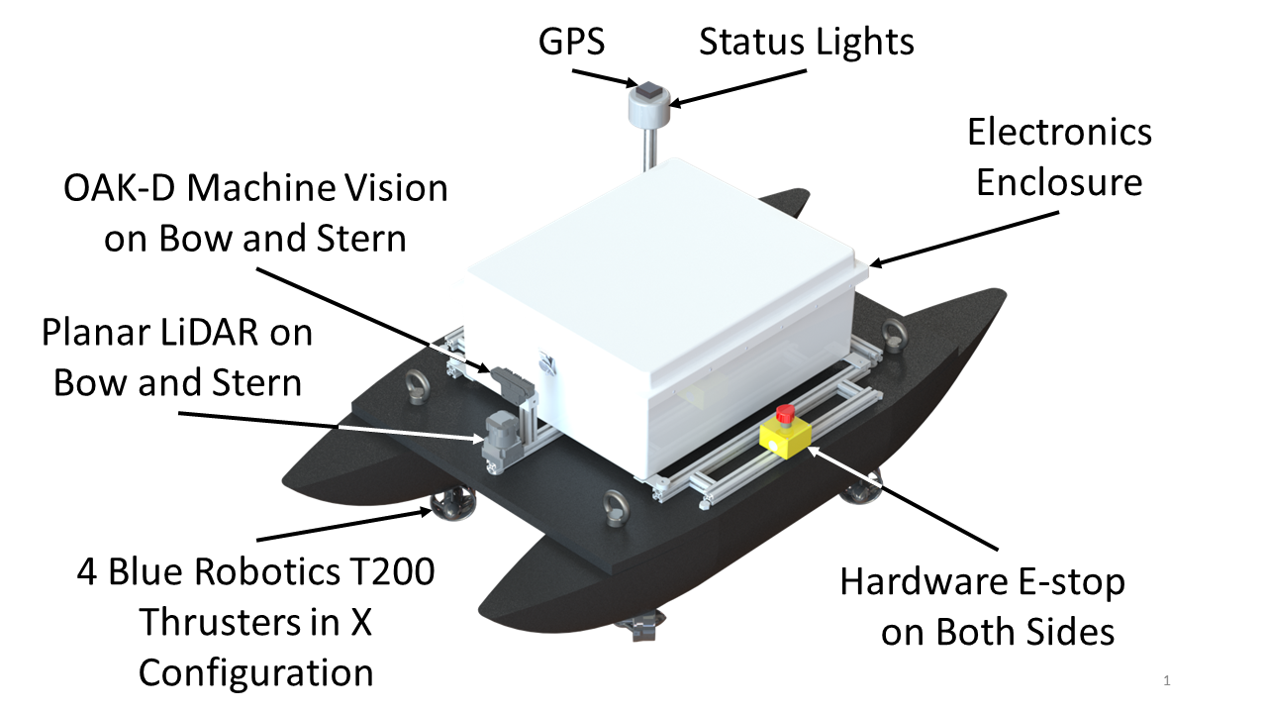
docs/images/New_ASV_CAD.png
