CRAWlab/RoboBoat-2021/docs/images/Simulated Drone.png

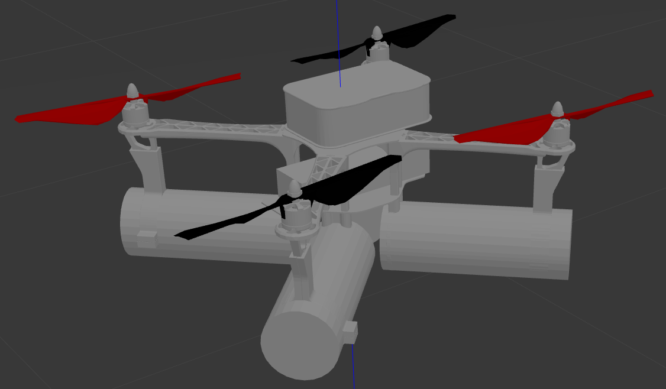
docs/images/Simulated Drone.png
