CRAWlab/RoboBoat-2021/docs/images/Teardown_ASV.jpg

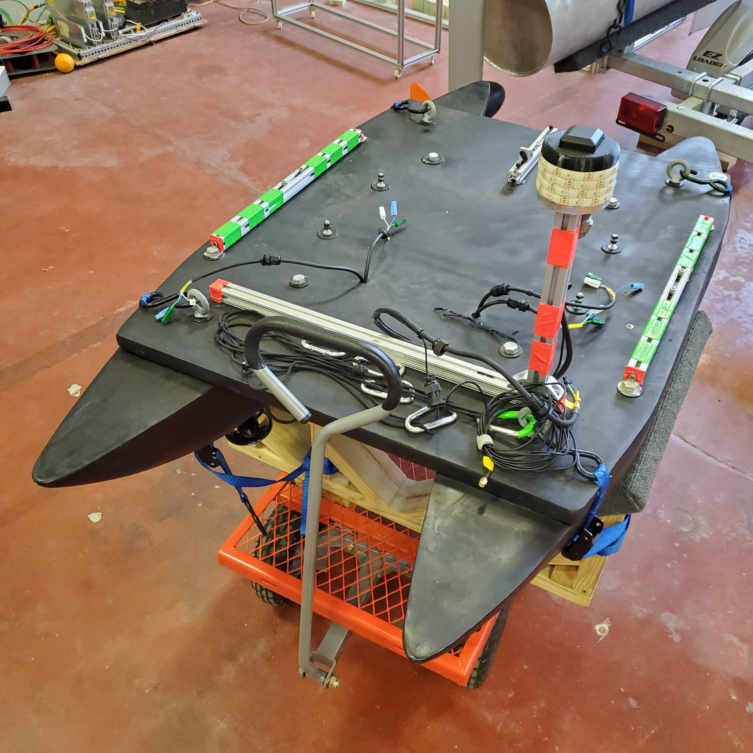
docs/images/Teardown_ASV.jpg
