CRAWlab/RoboBoat-2021/Internal Reporting/figures/mechanism_for_pickup_drop.PNG

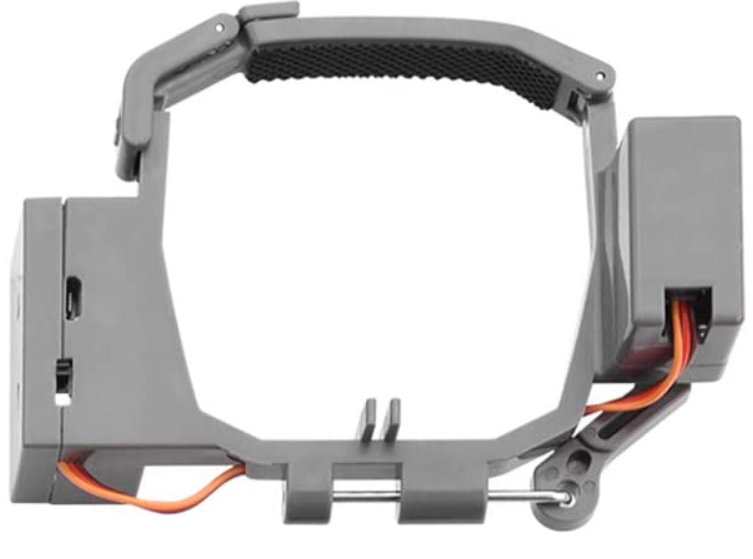
Internal Reporting/figures/mechanism_for_pickup_drop.PNG
