CRAWlab/RoboBoat-2021/Settings Files and Scripts/Blender/rendered_images_2021_04_24/IMG_00000000_rgb.png

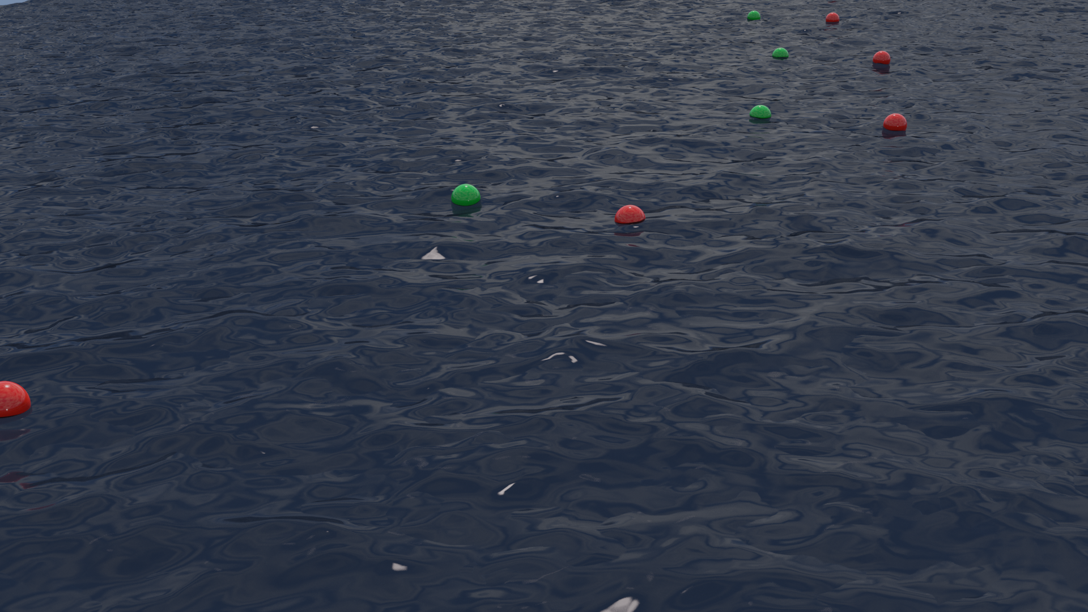
Settings Files and Scripts/Blender/rendered_images_2021_04_24/IMG_00000000_rgb.png
