CRAWlab/RoboBoat-2021/Settings Files and Scripts/Blender/rendered_images_2021_04_24/IMG_00000005_rgb.png

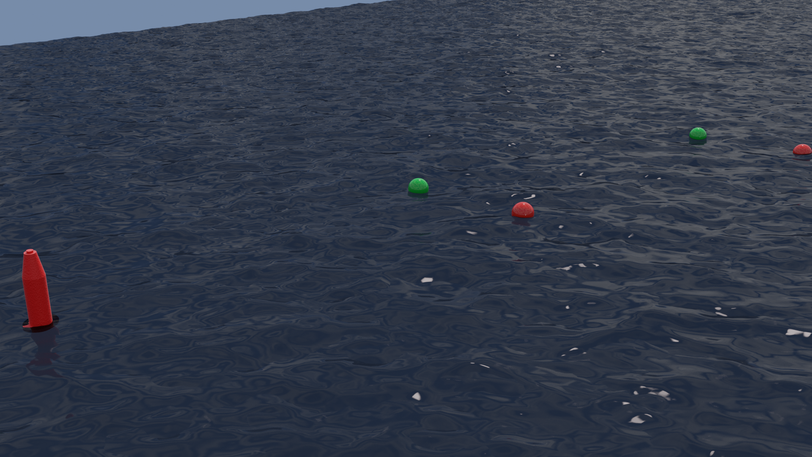
Settings Files and Scripts/Blender/rendered_images_2021_04_24/IMG_00000005_rgb.png
