CRAWlab/RoboBoat-2021/Settings Files and Scripts/Blender/segmented_bbox_images_2021_04_23/IMG_00000000_rgb_annotated.png

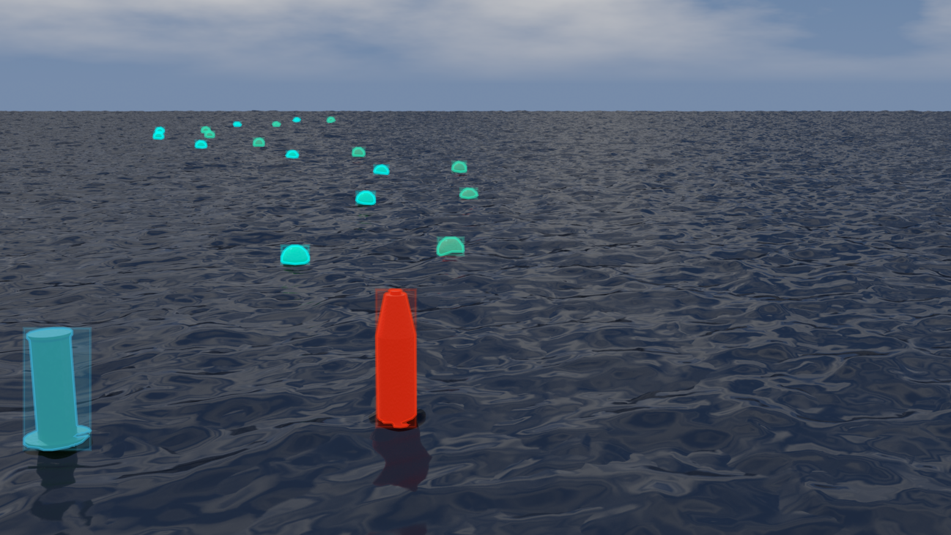
Settings Files and Scripts/Blender/segmented_bbox_images_2021_04_23/IMG_00000000_rgb_annotated.png
