CRAWlab/RoboBoat-2021/Settings Files and Scripts/YoloV4/train/IMG_00000000_rgb_png.rf.1d671d92b53079aaefb1ffac51b12758.jpg

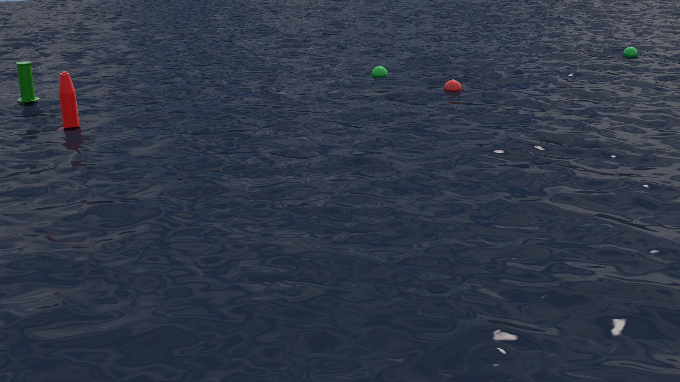
Settings Files and Scripts/YoloV4/train/IMG_00000000_rgb_png.rf.1d671d92b53079aaefb1ffac51b12758.jpg
