CRAWlab/RoboBoat-2021/Settings Files and Scripts/YoloV4/train/IMG_00000001_rgb_png.rf.a5ee9f9f82c750d5809fdc815ebff262.jpg

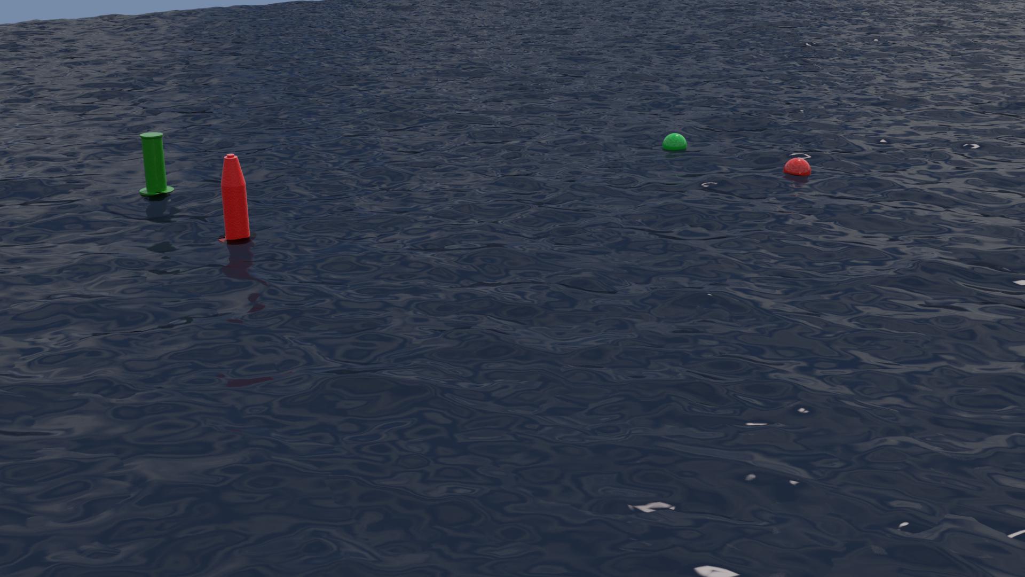
Settings Files and Scripts/YoloV4/train/IMG_00000001_rgb_png.rf.a5ee9f9f82c750d5809fdc815ebff262.jpg
