CRAWlab/RoboBoat-2021/Technical Report/2021_RaginCajunsRoboBoat_TDR/TDR/Figures/Acoustic_docking_FSM.png

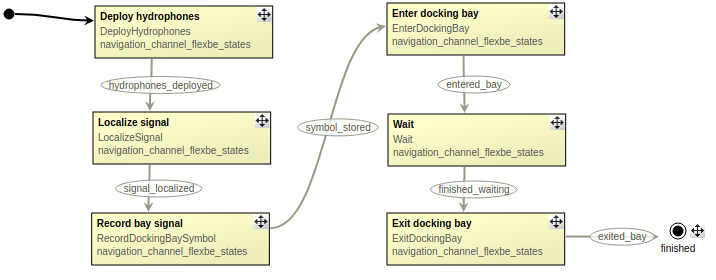
Technical Report/2021_RaginCajunsRoboBoat_TDR/TDR/Figures/Acoustic_docking_FSM.png
