CRAWlab/RoboBoat-2021/Technical Report/2021_RaginCajunsRoboBoat_TDR/TDR/Figures/Camera Mount Angle.png

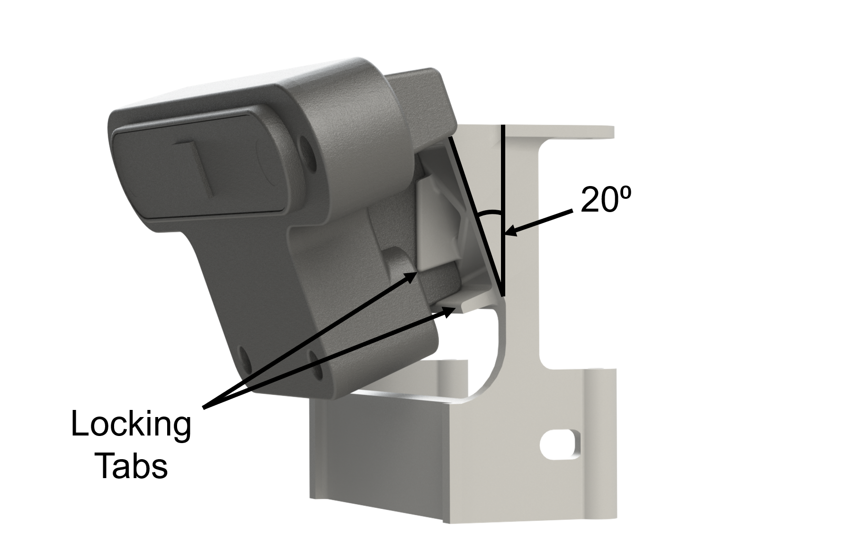
Technical Report/2021_RaginCajunsRoboBoat_TDR/TDR/Figures/Camera Mount Angle.png
