CRAWlab/RoboBoat-2021/Technical Report/2021_RaginCajunsRoboBoat_TDR/TDR/Figures/Catamaran Final Render 2.PNG

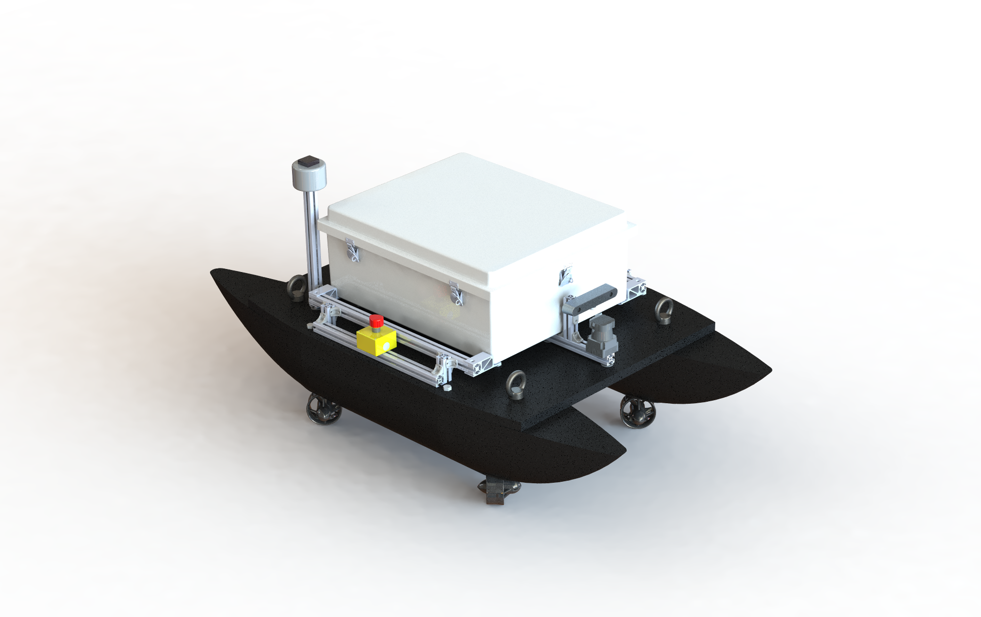
Technical Report/2021_RaginCajunsRoboBoat_TDR/TDR/Figures/Catamaran Final Render 2.PNG
