CRAWlab/RoboBoat-2021/Technical Report/2021_RaginCajunsRoboBoat_TDR/TDR/Figures/Catamaran Final Render - background Removed.png

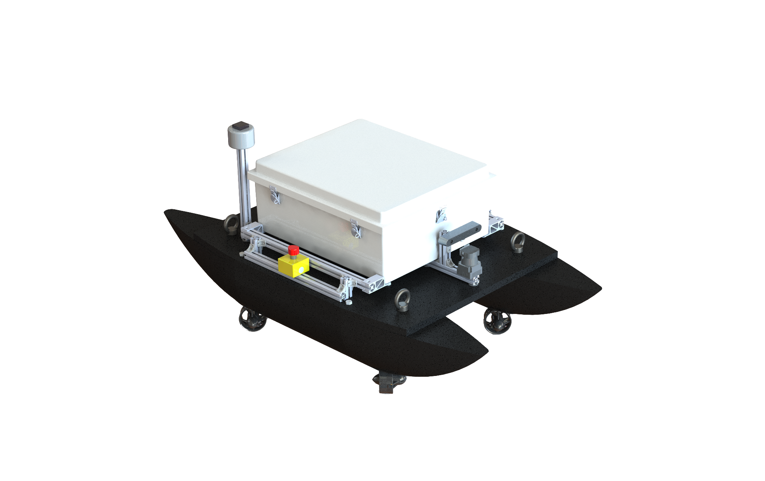
Technical Report/2021_RaginCajunsRoboBoat_TDR/TDR/Figures/Catamaran Final Render - background Removed.png
