CRAWlab/RoboBoat-2021/Technical Report/2021_RaginCajunsRoboBoat_TDR/TDR/Figures/Obstacle_field_FSM.png

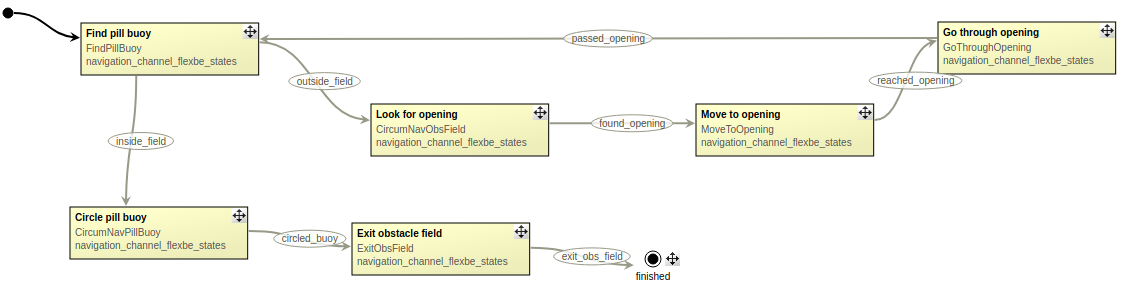
Technical Report/2021_RaginCajunsRoboBoat_TDR/TDR/Figures/Obstacle_field_FSM.png
