CRAWlab/RoboBoat-2021/Technical Report/2021_RaginCajunsRoboBoat_TDR/TDR/Figures/RoboBoat.png

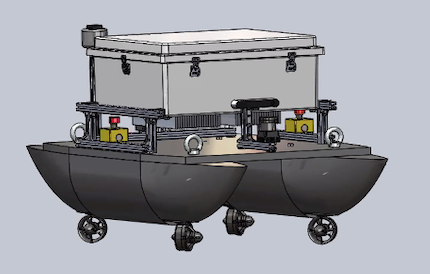
Technical Report/2021_RaginCajunsRoboBoat_TDR/TDR/Figures/RoboBoat.png
