CRAWlab/RoboBoat-2021/Drone Assembly/Figures/ESC & Motor/Motor Connectors.png

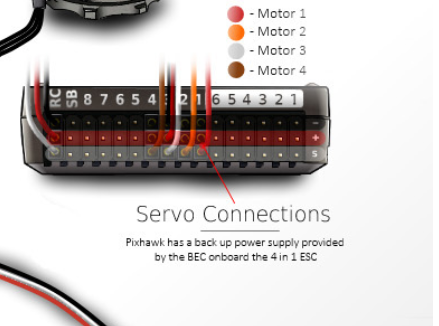
Drone Assembly/Figures/ESC & Motor/Motor Connectors.png
