CRAWlab/RoboBoat-2021/docs/images/UAV-Test_World-Cameras.png

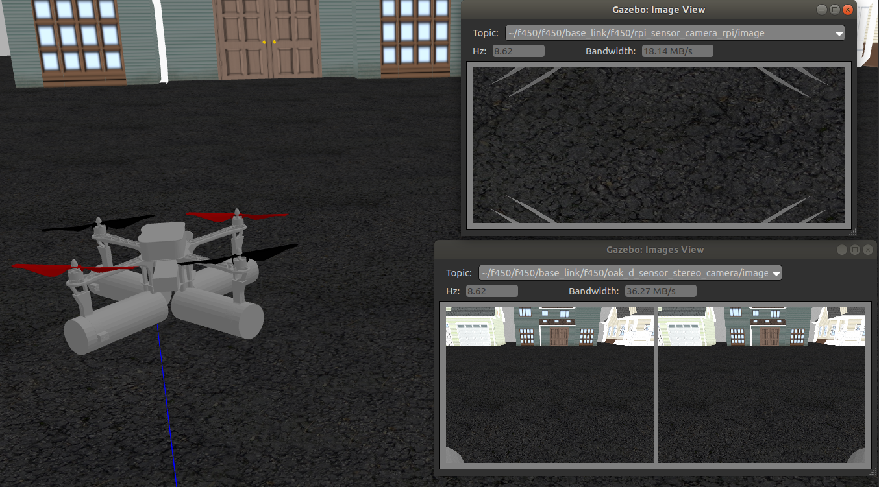
docs/images/UAV-Test_World-Cameras.png
