CRAWlab/RoboBoat-2021/docs/images/UAV-Test_World-Collisions.png

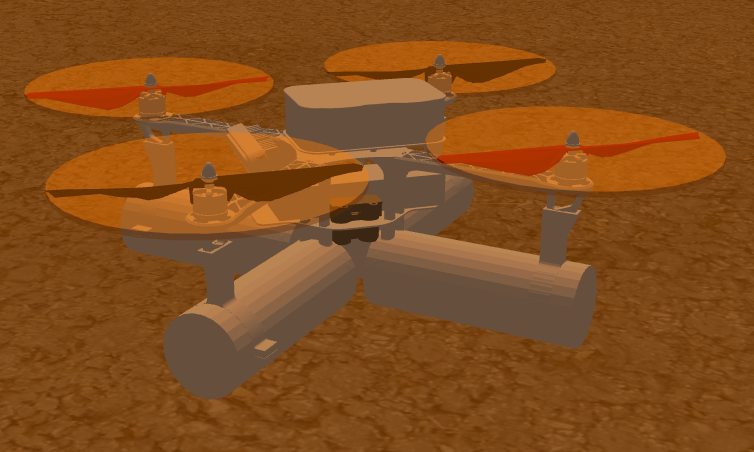
docs/images/UAV-Test_World-Collisions.png
