CRAWlab/RoboBoat-2021/docs/images/UAV-Test_World-Distance Sensor.png

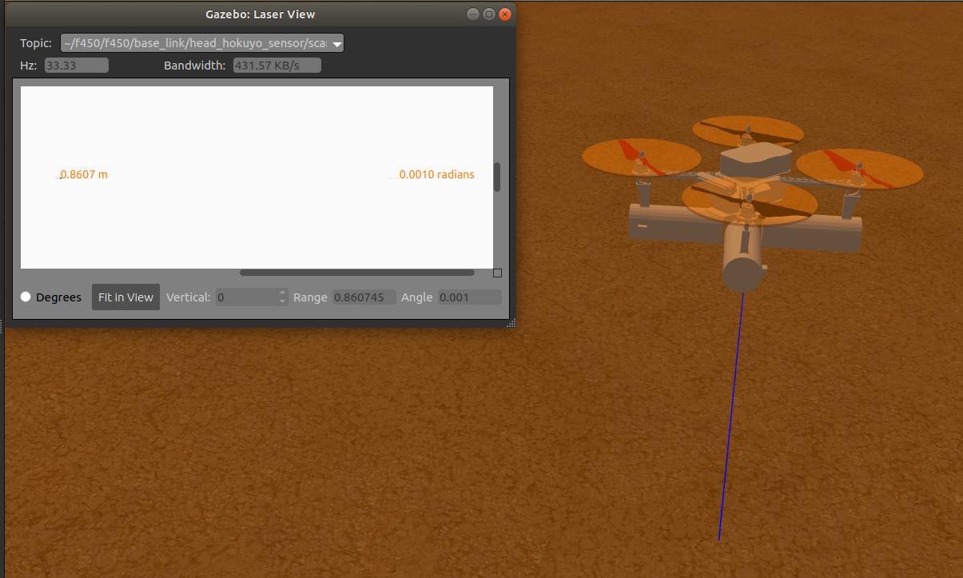
docs/images/UAV-Test_World-Distance Sensor.png
