CRAWlab/RoboBoat-2021/docs/images/UAV-Test_World.png

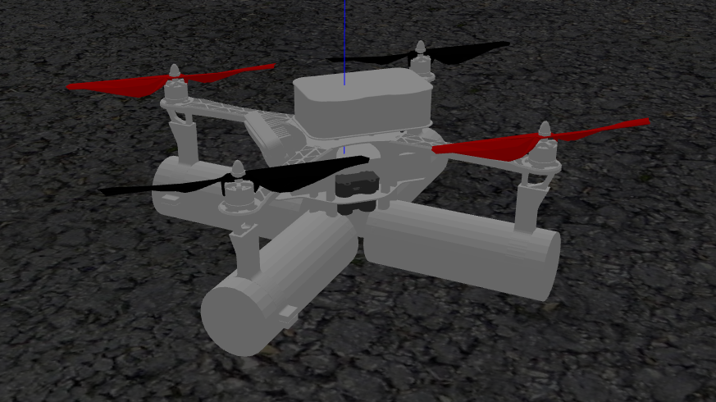
docs/images/UAV-Test_World.png
