CRAWlab/RoboBoat-2021/Technical Report/2021_RaginCajunsRoboBoat_TDR/TDR/Figures/ASV_fieldOfView_gray_v2.pdf

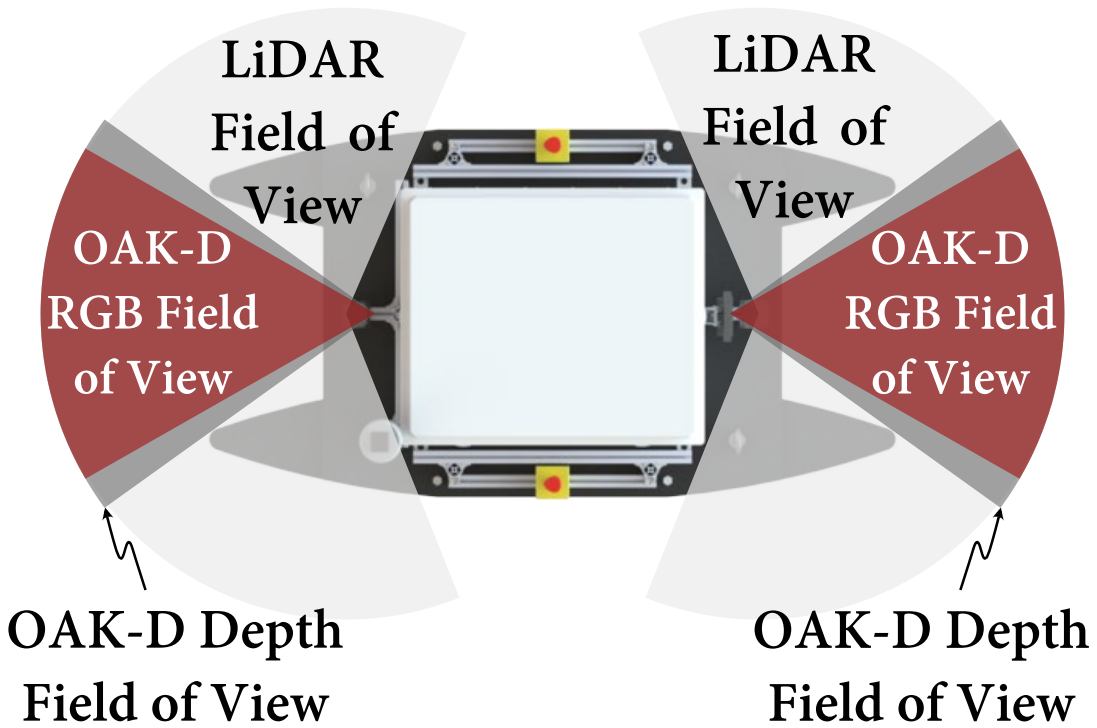
[picture p108: page 1]
LiDAR Field of View; OAK-D RGB Field of View

OAK-D Depth
Field of View
