CRAWlab/RoboBoat-2021/Technical Report/2021_RaginCajunsRoboBoat_TDR/TDR/Figures/ASV_fieldOfView_gray_v4_Adobe Devanagari.pdf

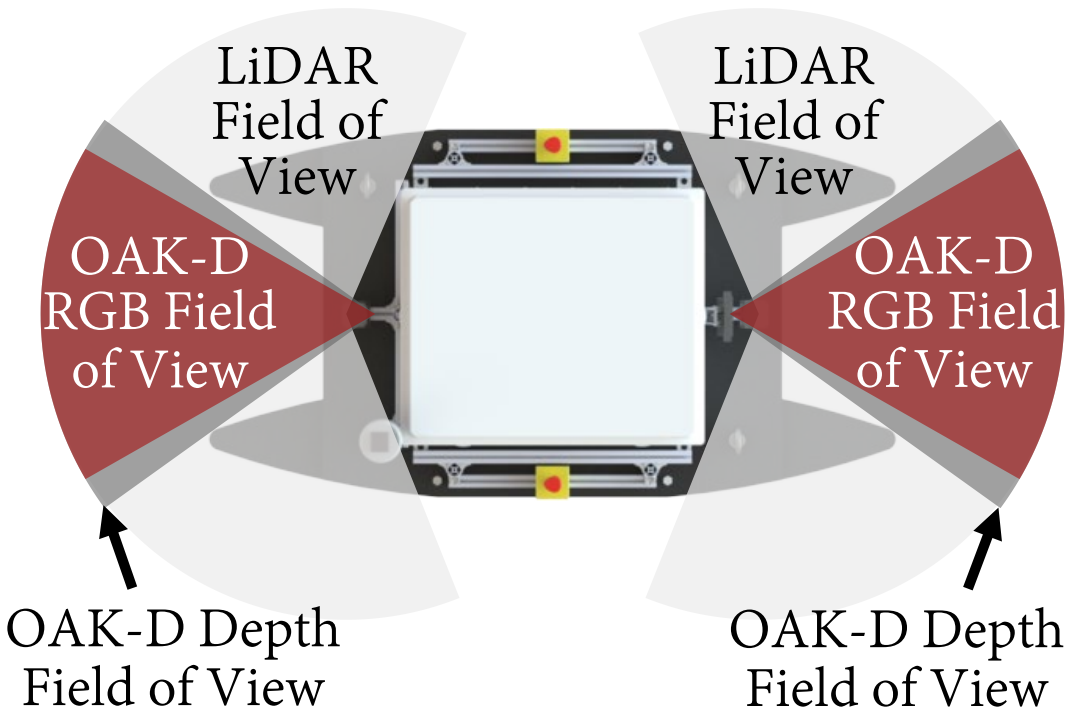
[picture p109: page 1]
LiDAR Field of View; OAK-D RGB Field of View; LiDAR Field of View OAK-D RGB Field of View

OAK-D Depth
Field of View
