CRAWlab/RoboBoat-2021/docs/files/Boats and Bros_05_06_19.pdf

# The RoboBoat Autonomous Surface Vehicle

## Christian Gary

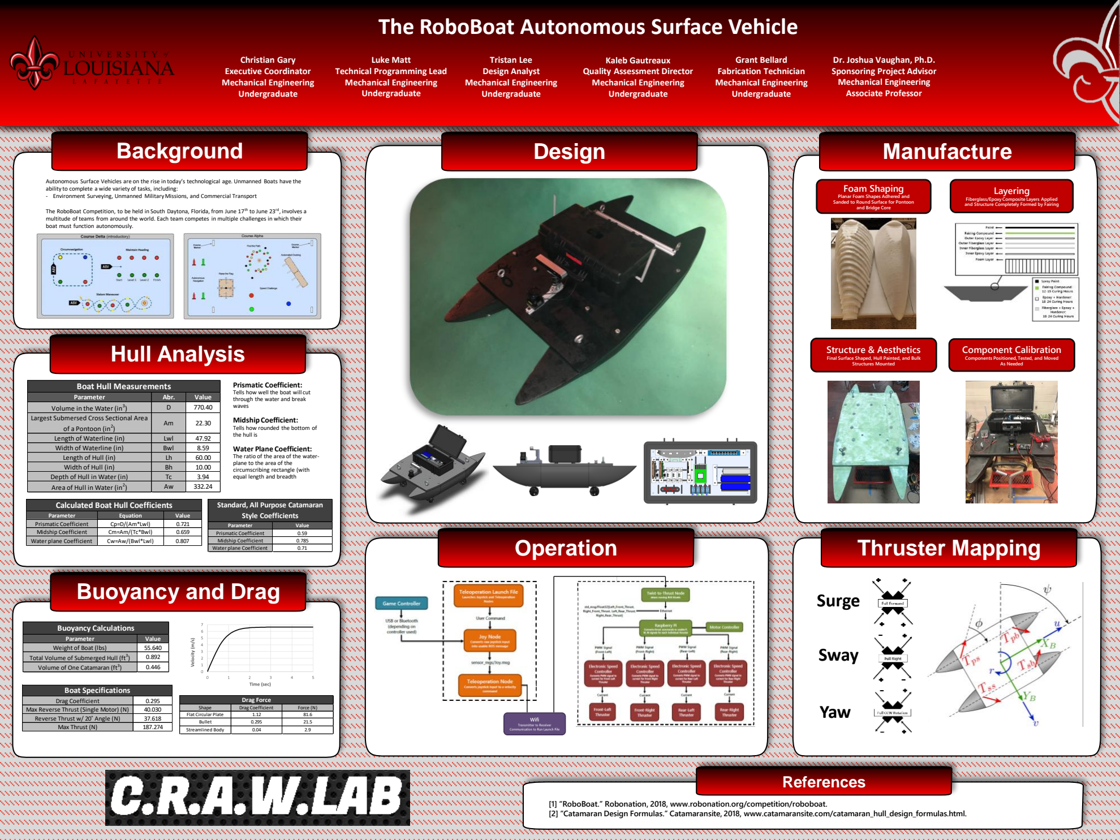
[picture p110: page 1]
Executive Coordinator Mechanical Engineering Undergraduate; Background; Operation; Hull Analysis; Design; Manufacture; Luke Matt; Tristan Lee Design Analyst Mechanical Engineering Undergraduate; Grant Bellard Fabrication Technician Mechanical Engineering Undergraduate; References; Foam Shaping; Layering; Structure & Aesthetics; Structures Mounted; Component Calibration; As Needed; Thruster Mapping; Sway; Surge; Yaw; Style Coefficients Shape; Drag Coefficient; Force (N); Buoyancy Calculations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

Dr. Joshua Vaughan, Ph.D.
Sponsoring Project Advisor
Mechanical Engineering
Associate Professor

Technical Programming Lead
Undergraduate

Kaleb Gautreaux
Quality Assessment Director

Autonomous Surface Vehicles are on the rise in today’s technological age. Unmanned Boats have the
ability to complete a wide variety of tasks, including:
- Environment Surveying, Unmanned Military Missions, and Commercial Transport

Planar Foam Shapes Adhered and
Sanded to Round Surface for Pontoon

Fiberglass/Epoxy Composite Layers Applied
and Structure Completely Formed by Fairing

The RoboBoat Competition, to be held in South Daytona, Florida, from June 17th to June 23rd, involves a
multitude of teams from around the world. Each team competes in multiple challenges in which their
boat must function autonomously.

and Bridge Core

Final Surface Shaped, Hull Painted, and Bulk

Components Positioned, Tested, and Moved

Boat Hull Measurements

Prismatic Coefficient:
Tells how well the boat will cut
through the water and break
waves
Midship Coefficient:
Tells how rounded the bottom of
the hull is
Water Plane Coefficient:
The ratio of the area of the water-
plane to the area of the
circumscribing rectangle (with
equal length and breadth

Volume in the Water (in³ ) | D | 770.40
Largest Submersed Cross Sectional Area of a Pontoon (in² ) | Am | 22.30

Parameter | Abr. | Value

Length of Waterline (in) | Bwl Lwl | 47.92 Width of Waterline (in) 8.59

Length of Hull (in) | Bh Lh | 60.00 Width of Hull (in) 10.00

Depth of Hull in Water (in) | Tc | 3.94
Area of Hull in Water (in² ) | Aw | 332.24

Calculated Boat Hull Coefficients | Standard, All Purpose Catamaran
Parameter | Equation | Value
Prismatic Coefficient | Cp=D/(Am*Lwl) | 0.721 | Parameter | Value
Midship Coefficient | Cm=Am/(Tc*Bwl) | 0.659 | Prismatic Coefficient | 0.59
Water plane Coefficient | Cw=Aw/(Bwl*Lwl) | 0.807 | Midship Coefficient | 0.785

Water plane Coefficient | 0.71

Buoyancy and Drag

Parameter | Value
Weight of Boat (lbs) | 55.640

Total Volume of Submerged Hull (ft³ ) | 0.892
Volume of One Catamaran (ft³ ) | 0.446

Drag Coefficient | 0.295 | Drag Force

Max Reverse Thrust (Single Motor) (N) | 40.030
Reverse Thrust w/ 20˚ Angle (N) | 37.618 | Flat Circular Plate | 1.12 | 81.6

Max Thrust (N) | 187.274 | Streamlined Body | 0.04 | 2.9

Bullet | 0.295 | 21.5

[1] “RoboBoat.” Robonation, 2018, www.robonation.org/competition/roboboat.
[2] “Catamaran Design Formulas.” Catamaransite, 2018, www.catamaransite.com/catamaran_hull_design_formulas.html.
