CRAWlab/RoboBoat-2021/Technical Report/2021_RaginCajunsRoboBoat_TDR/TDR/Figures/MPC_theory.pdf

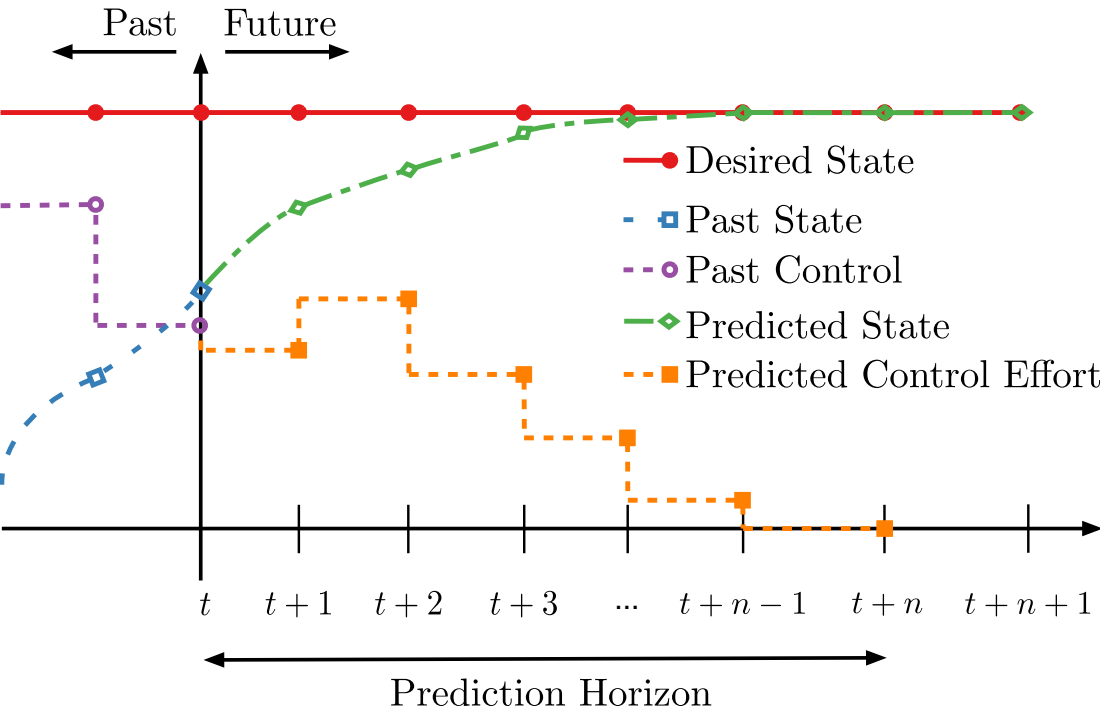
[picture p111: page 1]
