CRAWlab/RoboBoat-2021/Technical Report/2021_RaginCajunsRoboBoat_TDR/TDR/Figures/MPC_theory_tp1.pdf

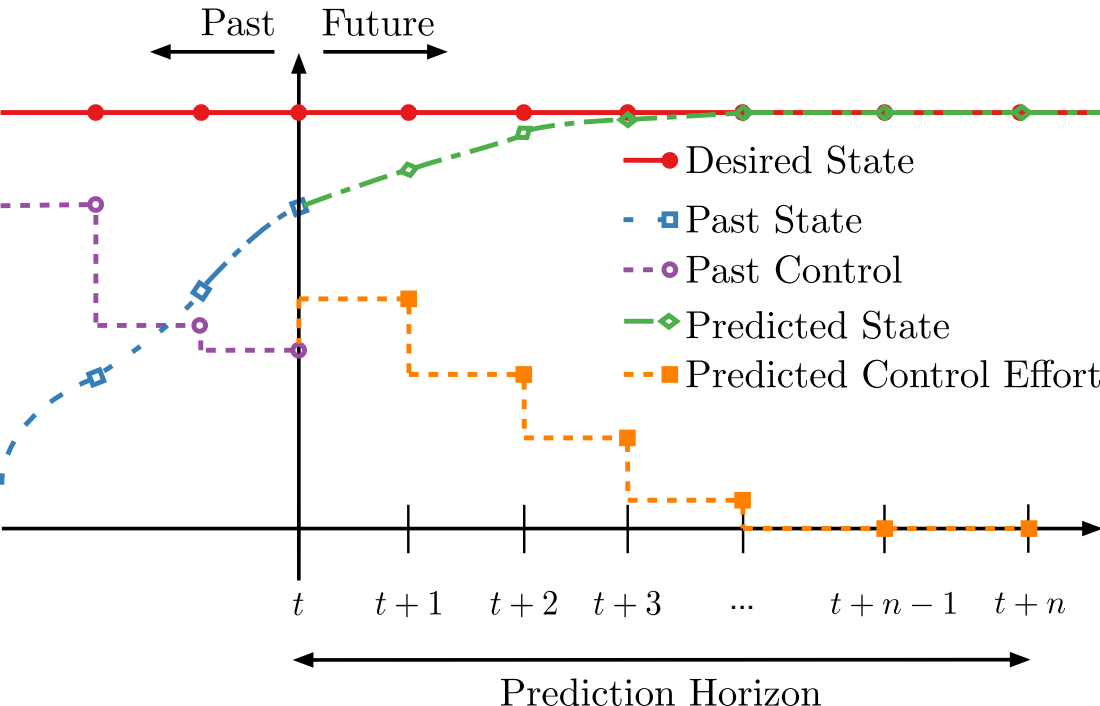
[picture p112: page 1]
