CRAWlab/RoboBoat-2021/Technical Report/2021_RaginCajunsRoboBoat_TDR/TDR/Figures/Catamaran_Final_Render_2.pdf

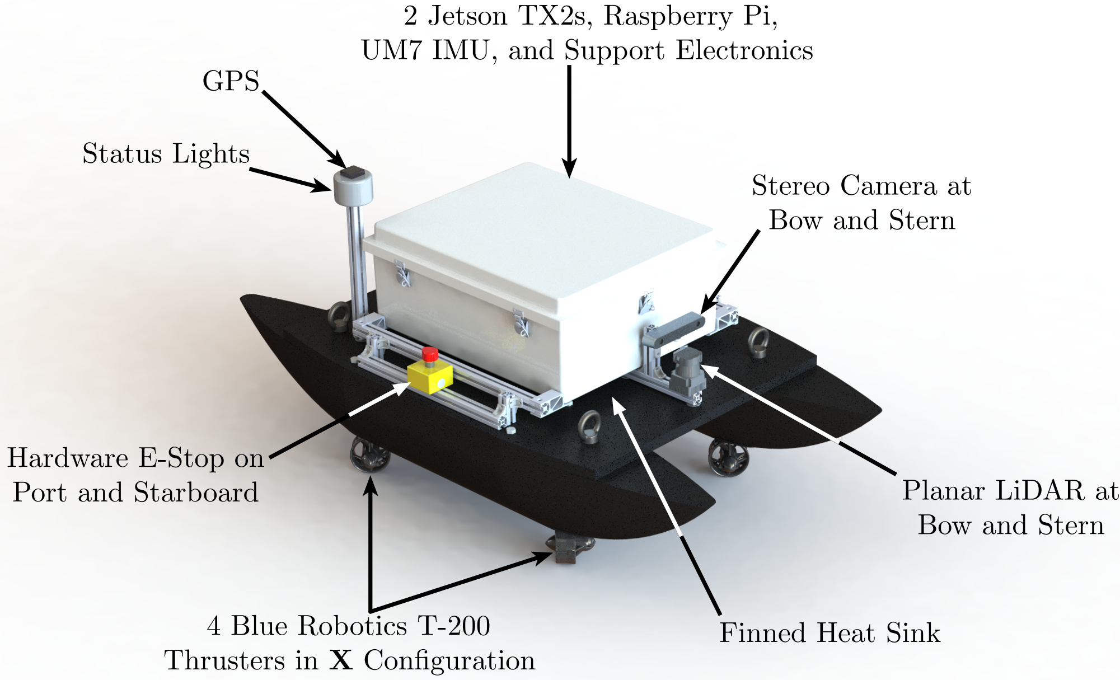
[picture p113: page 1]
