CRAWlab/RoboBoat-2021/(commit log)

2021-02-14 Update. Added realsense camera wrappers. WIP
    Still getting the "basics" installed
2021-03-23 Added xacro and Dockerfile for f450
    [f450.xacro, f450_base.xacro]
2021-04-21 Updates to the Configuration of the Webpage: Added .md files for each section and started creating buttons for pages
2021-04-21 Some more updates to the page: Added buttons in mostly correct orientation
2021-04-21 Updates to Links in Buttons
2021-04-25 Updates: Added content to a few different sections
    [Senior Project Gantt_2021_04_19.xlsx]
